nmikstas/atari_pokey/README.md

# atari_pokey
Recreation of the Atari POKEY chip (work in progress)
