nmikstas/atari_pokey/Documents/FPGA_POKEY_Schematic/page1.png

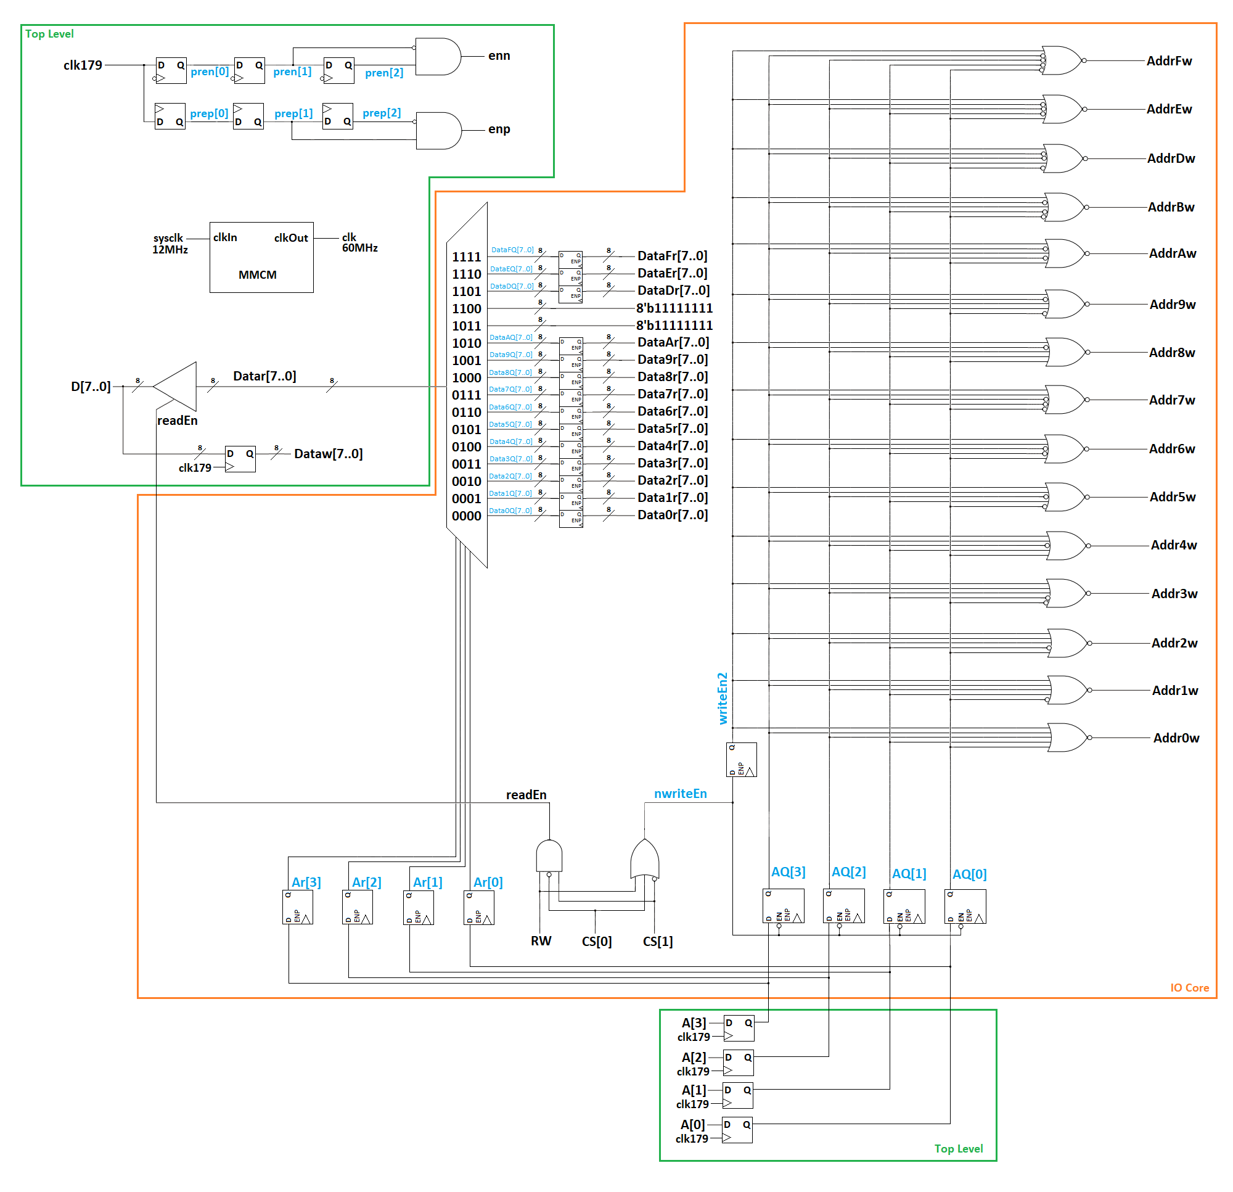
Documents/FPGA_POKEY_Schematic/page1.png
