nmikstas/atari_pokey/Documents/FPGA_POKEY_Schematic/page2.png

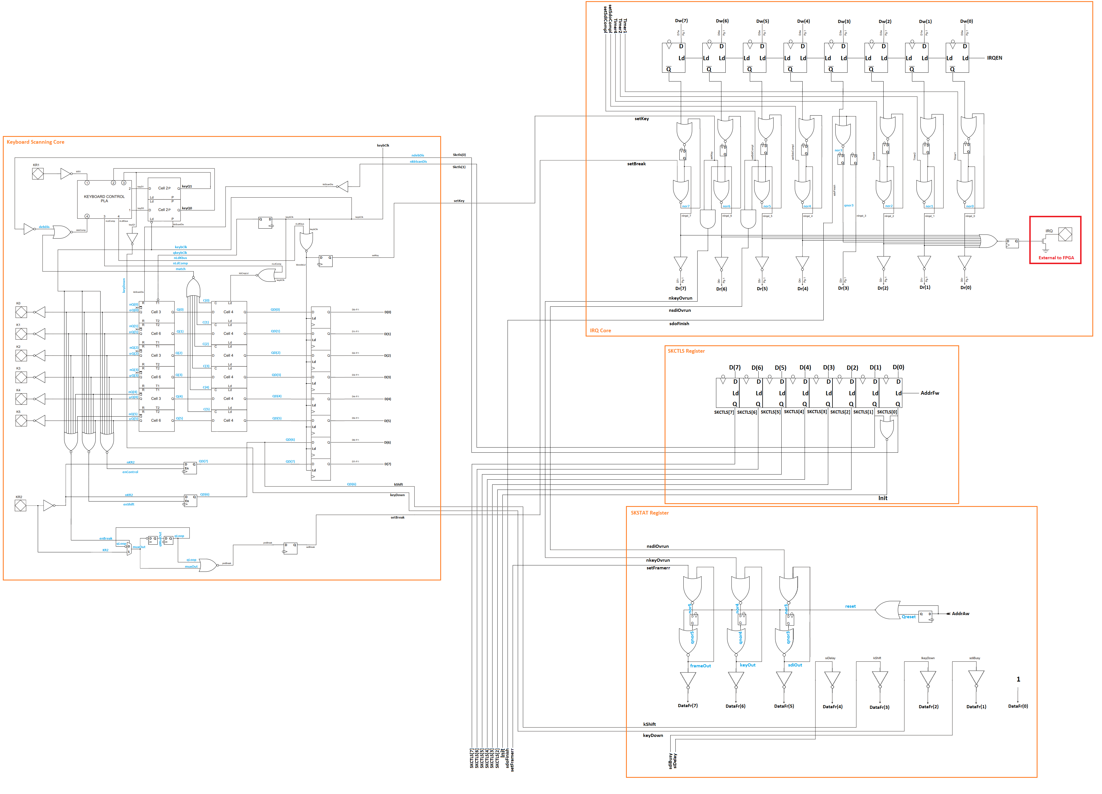
Documents/FPGA_POKEY_Schematic/page2.png
