nmikstas/atari_pokey/Documents/FPGA_POKEY_Schematic/page3.png

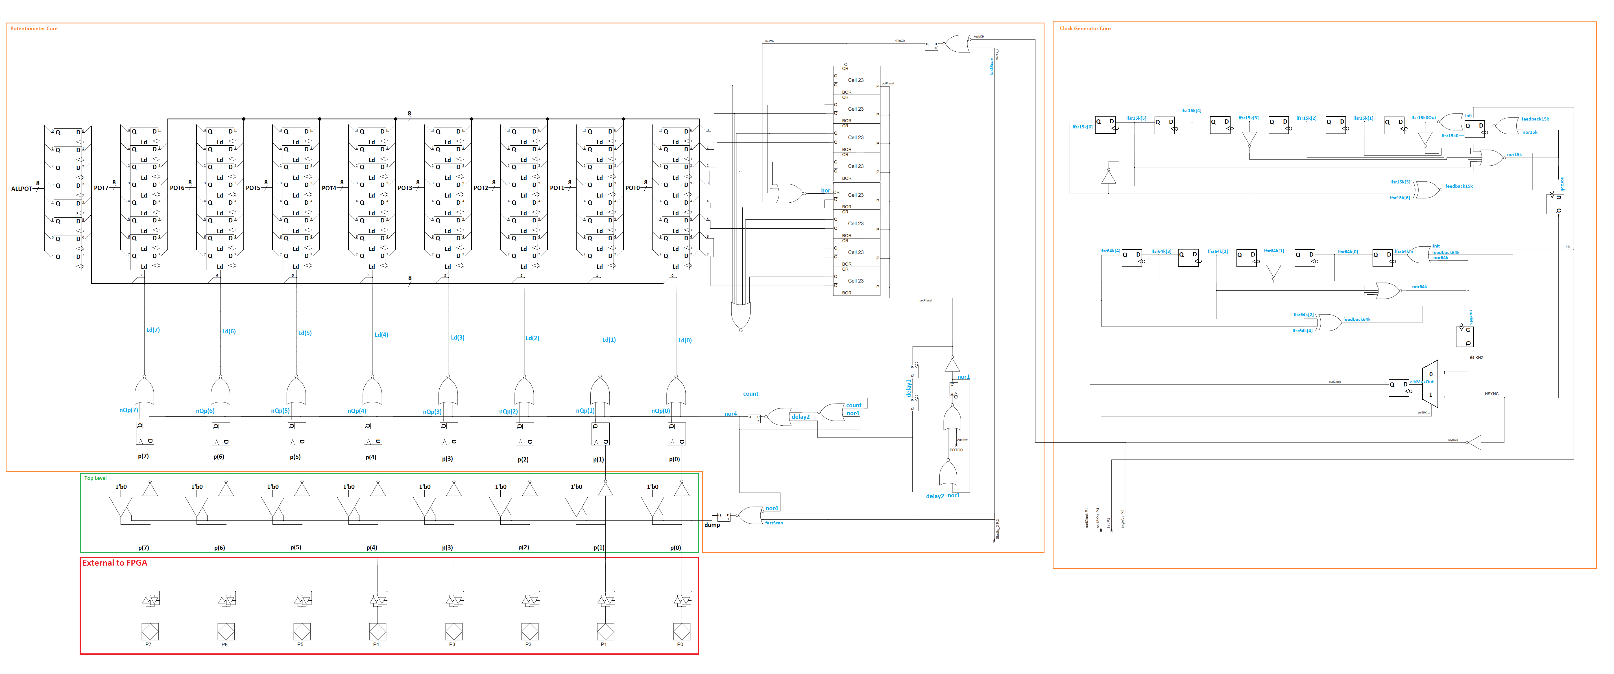
Documents/FPGA_POKEY_Schematic/page3.png
