nmikstas/atari_pokey/Documents/FPGA_POKEY_Schematic/page4.png

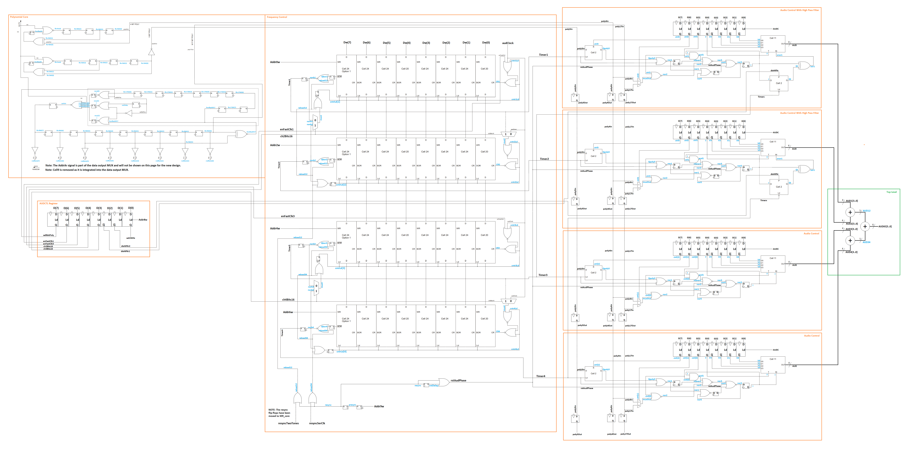
Documents/FPGA_POKEY_Schematic/page4.png
