nmikstas/atari_pokey/Documents/FPGA_POKEY_Schematic/page5.png

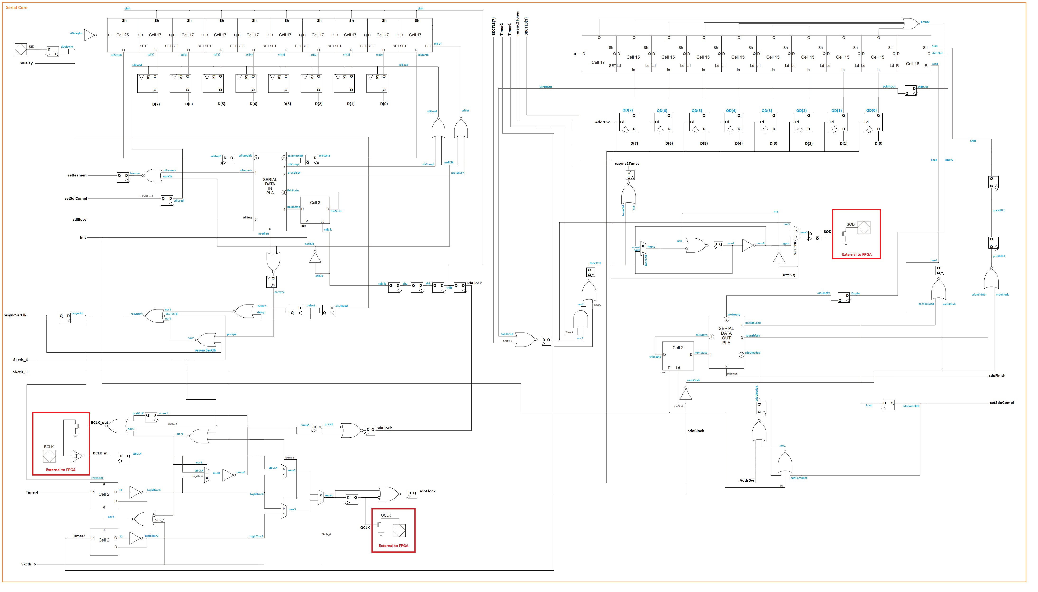
Documents/FPGA_POKEY_Schematic/page5.png
