nmikstas/atari_pokey/Documents/FPGA_POKEY_Schematic/page6.png

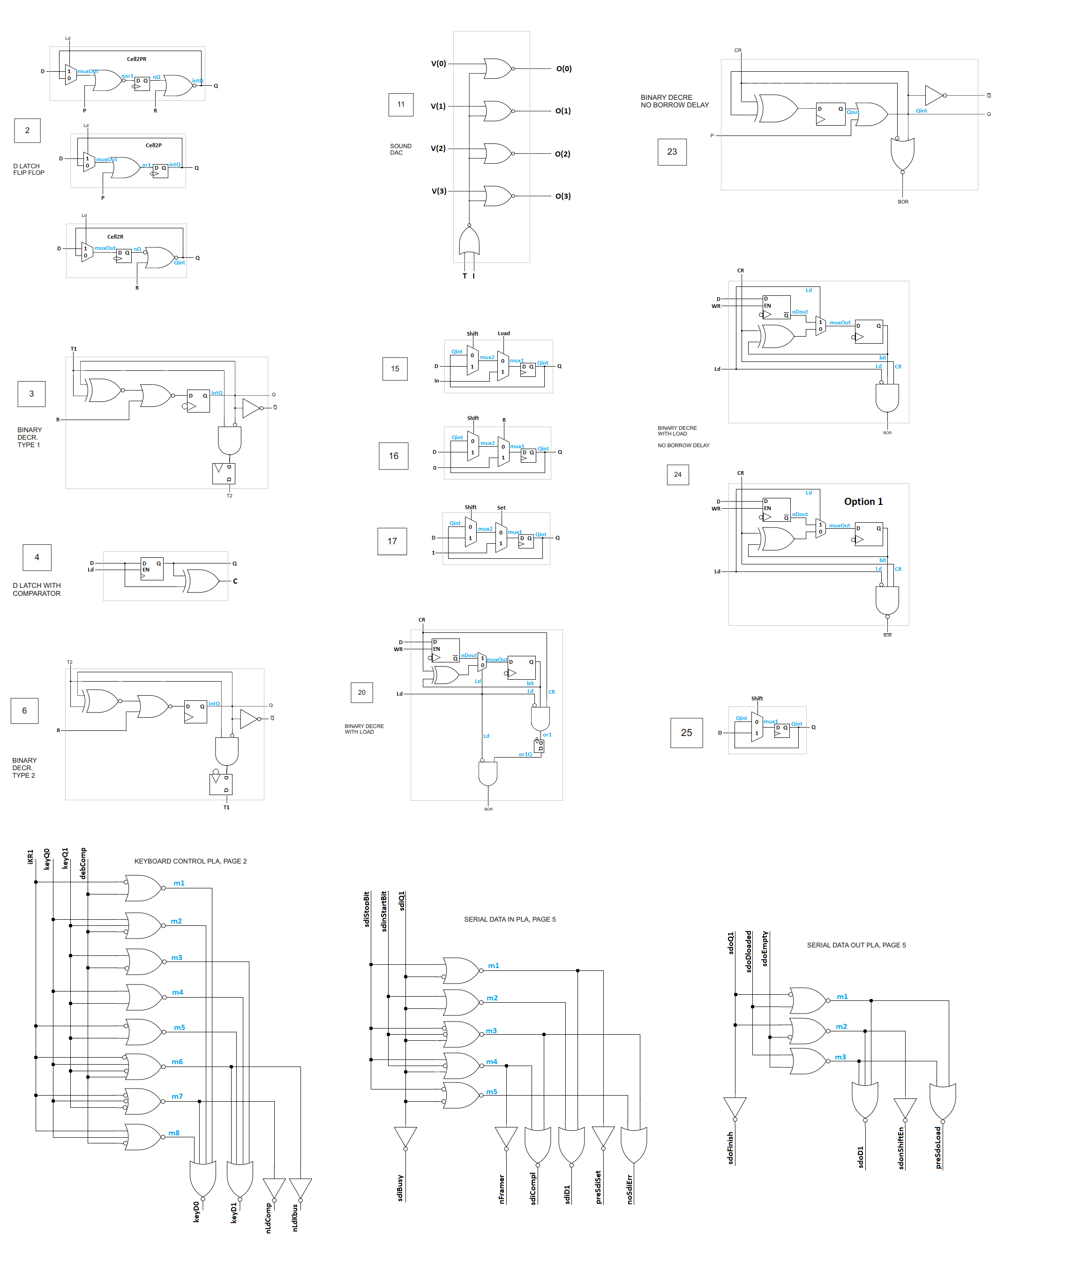
Documents/FPGA_POKEY_Schematic/page6.png
