nmikstas/atari_pokey/PCB/Prototype2/Manufacturing_Files/Prototype2.xls

Sheet: PCB Specification
Your PCB Specification
PCB Quantity | 5
Layer | 4
PCB Thickness | 1.6mm
Dimensions | 51mm x 64mm
Castellated Hole | No
PCB Color | Blue
Surface Finish
Copper Weight | 1 Oz
Text Color | White
Different Design | 1
Please find more PCB information on our on-line PCB ordering Page
https://www.elecrow.com/pcb-manufacturing.html

Sheet: BOM
BOM
Reference | QTY | Value | Package | Manufacturer Part number | Description | Part Number
C1 C2 C3 C4 C5 C6 C7 C8 C9 C10 | 10 | .1uf | 0201 (0603 Metric) | 0201X104K160CT | CAP CER 0.1UF 16V X5R 0201 | Digikey 1292-1161-1-ND or equivalent
C11 | 1 | 10uf | 0805 (2012 Metric) | CL21A106KOQNNNE | CAP CER 10UF 16V X5R 0805 | Digikey 1276-1096-1-ND or equivalent
Q1 Q2 Q3 Q4 Q5 Q6 Q7 Q8 Q9 Q10 Q11 Q12 Q13 Q14 Q15 Q16 Q17 Q18 | 18 | SSM3K72KCT | SC-101, SOT-883 | SSM3K72KCT,L3F | MOSFET N-CH 60V 400MA CST3 | Digikey SSM3K72KCTL3FCT-ND or equivalent
R1 | 1 | 825 1% | 0402 (1005 Metric) | RC0402FR-07825RL | RES 825 OHM 1% 1/16W 0402 | Digikey YAG3242CT-ND or equivalent
R2 | 1 | 1.65K 1% | 0201 (0603 Metric) | RC0201FR-071K65L | RES 1.65K OHM 1% 1/20W 0201 | Digikey YAG2486CT-ND or equivalent
R3 | 1 | 3.3K 1% | 0201 (0603 Metric) | RC0201FR-073K3L | RES 3.3K OHM 1% 1/20W 0201 | Digikey YAG2285CT-ND or equivalent
R4 | 1 | 7.68K 1% | 0201 (0603 Metric) | RC0201FR-077K68L | RES 7.68K OHM 1% 1/20W 0201 | Digikey YAG2806CT-ND or equivalent
R5 | 1 | 24K 1% | 0201 (0603 Metric) | RC0201FR-0724KL | RES 24K OHM 1% 1/20W 0201 | Digikey YAG2336CT-ND or equivalent
R6 | 1 | 75K 1% | 0201 (0603 Metric) | RC0201FR-0775KL | RES 75K OHM 1% 1/20W 0201 | Digikey YAG2795CT-ND or equivalent
U1 | 1 | 74LVC1G97 | 6-UFDFN | SN74LVC1G97DRYR | IC CONFIG MULTI-FUNC GATE 6SON | 296-29874-1-ND or equivalent
U2 | 1 | 74LVC245 | 20-VFQFN Exposed Pad | 74LVC245ABQ,115 | IC TXRX NON-INVERT 3.6V 20DHVQFN | 1727-3495-1-ND or equivalent
U3 U4 U5 | 3 | 74LVC3G14 | 8-XFDFN | 74LVC3G14GT,115 | IC INVERT SCHMITT 3CH 3INP 8XSON | 1727-7042-1-ND or equivalent
U6 U7 U8 U9 | 4 | 74LVC125 | 14-VFQFN Exposed Pad | 74LVC125ABQ,115 | IC BUF NON-INVERT 3.6V 14DHVQFN | 1727-3481-1-ND or equivalent
U10 | 1 | LD1117S33TR | SOT-223 | LD1117S33TR | IC REG LINEAR 3.3V 800MA SOT223 | 497-1242-1-ND or equivalent
TP1 TP2 TP3 TP4 TP5 TP6 TP7 TP8 TP9 TP10 TP11 TP12 TP13 TP14 TP15 TP16 TP17 TP18 TP19 TP20 TP21 TP22 TP23 TP24 TP25 TP26 TP27 TP28 TP29 TP30 TP31 TP32 TP33 TP34 TP35 TP36 TP37 TP38 TP39 TP40 TP41 TP42 TP43 TP44 TP45 TP46 | 46 | Not Populated
R6 | 1 | Not Populated
J2 | 1 | Not Populated
J3 | 1 | Not Populated

Sheet: Parts Mapping
Top View | Bottom View

Sheet: Position File
Designator | Footprint | Center-X(mm) | Center-Y(mm) | Layer | Rotation
C1 | C_0201_0603Metric | 172.212 | -71.2368 | Top | -90
C2 | C_0201_0603Metric | 183.2102 | -110.8495 | Top | -90
C3 | C_0201_0603Metric | 165.989 | -114.0816 | Top | -90
C4 | C_0201_0603Metric | 166.0678 | -103.886 | Top | 180
C5 | C_0201_0603Metric | 182.8292 | -82.5729 | Top | -90
C6 | C_0201_0603Metric | 166.0848 | -96.2660 | Top | 180
C7 | C_0201_0603Metric | 166.1322 | -88.6420 | Top | 180
C8 | C_0201_0603Metric | 174.3812 | -92.7100 | Top | 0.0000
C9 | C_0201_0603Metric | 156.3776 | -62.6872 | Top | 0.0000
C10 | C_0201_0603Metric | 165.989 | -80.7572 | Top | -90
C11 | C_0805_2012Metric | 156.337 | -60.2640 | Top | 90.0000
Q1 | CST3_TOS | 184.2135 | -74.9300 | Top | 0.0000
Q2 | CST3_TOS | 188.2775 | -74.93 | Top | 180
Q3 | CST3_TOS | 184.2135 | -73.4060 | Top | 0.0000
Q4 | CST3_TOS | 188.2775 | -73.4060 | Top | 180
Q5 | CST3_TOS | 184.2135 | -71.8820 | Top | 0.0000
Q6 | CST3_TOS | 188.2775 | -71.8820 | Top | 180
Q7 | CST3_TOS | 162.814 | -101.5365 | Top | -90
Q8 | CST3_TOS | 162.814 | -104.0765 | Top | -90
Q9 | CST3_TOS | 162.814 | -96.4565 | Top | -90
Q10 | CST3_TOS | 162.814 | -98.9965 | Top | -90
Q11 | CST3_TOS | 162.814 | -91.3765 | Top | -90
Q12 | CST3_TOS | 162.814 | -93.9165 | Top | -90
Q13 | CST3_TOS | 162.814 | -86.2965 | Top | -90
Q14 | CST3_TOS | 162.814 | -88.8365 | Top | -90
Q15 | CST3_TOS | 181.9783 | -104.1400 | Top | 180
Q16 | CST3_TOS | 181.9529 | -101.6000 | Top | 180
Q17 | CST3_TOS | 181.864 | -96.5200 | Top | 180
Q18 | CST3_TOS | 181.9275 | -99.0600 | Top | 180
R1 | R_0402_1005Metric | 185.674 | -75.186 | Top | -90
R2 | R_0201_0603Metric | 186.944 | -75.021 | Top | -90
R3 | R_0201_0603Metric | 185.674 | -73.406 | Top | 90.0000
R4 | R_0201_0603Metric | 186.944 | -73.315 | Top | 90.0000
R5 | R_0201_0603Metric | 185.674 | -71.791 | Top | -90
R6 | R_0201_0603Metric | 186.944 | -71.719 | Top | -90
U1 | DRY6 | 172.4516 | -92.7100 | Top | 0.0000
U2 | VQFN20_RKS_TEX | 168.6757 | -70.6882 | Top | -90
U3 | XSON8 | 168.4408 | -104.1324 | Top | 90.0000
U4 | XSON8 | 168.4408 | -96.5022 | Top | 90.0000
U5 | XSON8 | 168.4408 | -88.9330 | Top | 90.0000
U6 | DHVQFN14_SOT762-1_NEX | 168.7068 | -114.1476 | Top | 90.0000
U7 | DHVQFN14_SOT762-1_NEX | 185.8772 | -110.8964 | Top | 90.0000
U8 | DHVQFN14_SOT762-1_NEX | 168.7068 | -80.7720 | Top | 90.0000
U9 | DHVQFN14_SOT762-1_NEX | 185.6232 | -82.6389 | Top | 90.0000
U10 | SOT-223 | 162.535 | -61.8490 | Top | 0.0000
