nmikstas/atari_pokey/PCB/Through_Hole_Single_Lattice/Through_Hole_Single.kicad_pcb

## KiCad design PCB/Through_Hole_Single_Lattice/Through_Hole_Single.kicad_pcb (2024-12-10)

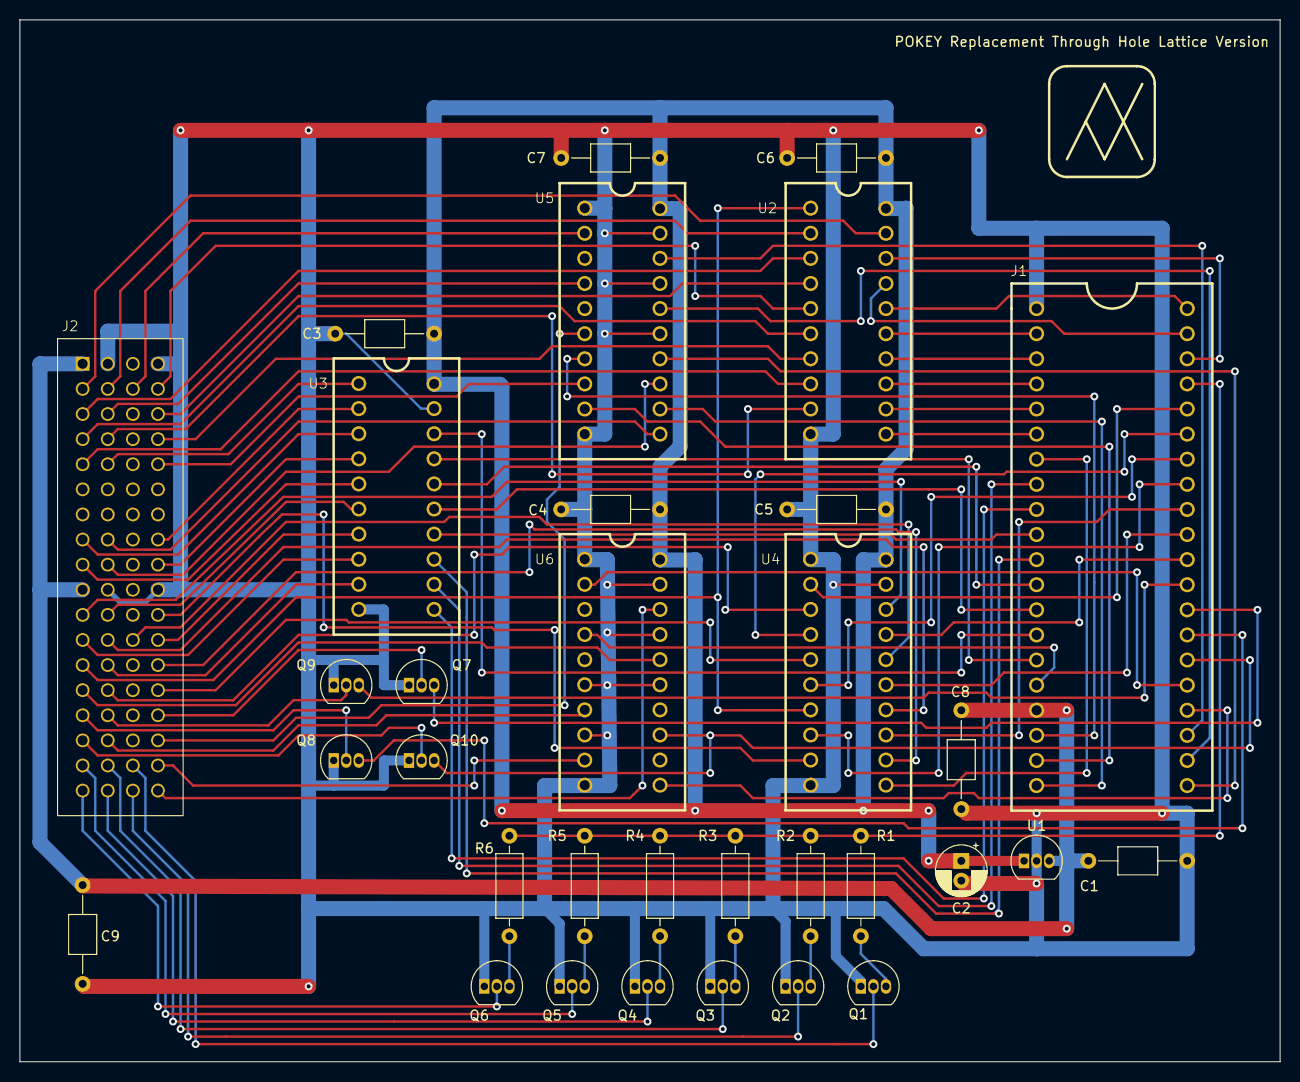
[picture p7: board Through_Hole_Single.kicad_pcb from above]

Board: 2 copper layers, 127.5 x 105.4 mm, 33 parts (0 on the bottom side), 93 nets.

Parts:
C1, C3, C4, C5, C6, C7, C8, C9: .1uf; C_Axial_L3.8mm_D2.6mm_P10.00mm_Horizontal
C2: 10uf; CP_Radial_D5.0mm_P2.00mm
J1: 2x20_Conn; Con_2X20
J2: Proto-72Pin
Q1, Q2, Q3, Q4, Q5, Q6, Q7, Q8, Q9, Q10: TN2106; TO-92_Inline
R1: 825 1%; R_Axial_DIN0207_L6.3mm_D2.5mm_P10.16mm_Horizontal
R2: 1.65K 1%; R_Axial_DIN0207_L6.3mm_D2.5mm_P10.16mm_Horizontal
R3: 3.3K 1%; R_Axial_DIN0207_L6.3mm_D2.5mm_P10.16mm_Horizontal
R4: 7.68K 1%; R_Axial_DIN0207_L6.3mm_D2.5mm_P10.16mm_Horizontal
R5: 24K 1%; R_Axial_DIN0207_L6.3mm_D2.5mm_P10.16mm_Horizontal
R6: 75K 1%; R_Axial_DIN0207_L6.3mm_D2.5mm_P10.16mm_Horizontal
U1: L78L05_TO92; TO-92_Inline
U2, U3, U4, U5, U6: DIP_20

Connections:
+3.3V: C2.1, C3.1, C4.1, C5.1, C6.1, C7.1, U1.1 (VO), U2.20 (VCC), U3.20 (VCC), U4.20 (VCC), U5.20 (VCC), U6.20 (VCC)
+5V: C1.1, C8.1, C9.1, J1.17 (+5V), J2.1 (5V1), J2.37 (5V2), U1.3 (VI)
A0: J1.36 (A0), U4.2 (1A1)
A1: J1.35 (A1), U4.4 (1A2)
A2: J1.34 (A2), U4.6 (1A3)
A3: J1.33 (A3), U4.8 (1A4)
AUDIO: J1.37 (AUDIO), R1.1, R2.1, R3.1, R4.1, R5.1, R6.1
BCLK: J1.26 (BCLK), Q10.3 (D), U6.13 (2A2)
CS1: J1.31 (CS1), U4.15 (2A3)
D0: J1.38 (D0), U2.18 (B0)
D1: J1.39 (D1), U2.17 (B1)
D2: J1.40 (D2), U2.16 (B2)
D3: J1.2 (D3), U2.15 (B3)
D4: J1.3 (D4), U2.14 (B4)
D5: J1.4 (D5), U2.13 (B5)
D6: J1.5 (D6), U2.12 (B6)
D7: J1.6 (D7), U2.11 (B7)
GND: C1.2, C2.2, C3.2, C4.2, C5.2, C6.2, C7.2, C8.2, C9.2, J1.1 (GND), J2.2 (G1), J2.4 (G2), J2.38 (G3), J2.40 (G4), Q1.1 (S), Q2.1 (S), Q3.1 (S), Q4.1 (S), Q5.1 (S), Q6.1 (S), Q7.1 (S), Q8.1 (S), Q9.1 (S), Q10.1 (S), U1.2 (GND), U2.10 (GND), U3.10 (GND), U3.19 (CE), U4.1 (1~OE), U4.10 (GND), U4.19 (2~OE), U5.1 (1~OE), U5.10 (GND), U5.15 (2A3), U5.17 (2A4), U5.19 (2~OE), U6.1 (1~OE), U6.6 (1A3), U6.8 (1A4), U6.10 (GND), U6.15 (2A3), U6.17 (2A4), U6.19 (2~OE)
unnamed: Q1.3 (D), R1.2
unnamed: Q2.3 (D), R2.2
unnamed: Q3.3 (D), R3.2
unnamed: Q4.3 (D), R4.2
unnamed: Q5.3 (D), R5.2
unnamed: Q6.3 (D), R6.2
OCLK: J1.27 (OCLK), Q8.3 (D)
P0: J1.14 (P0), U3.18 (B0)
P1: J1.15 (P1), U3.17 (B1)
P2: J1.12 (P2), U3.16 (B2)
P3: J1.13 (P3), U3.15 (B3)
P4: J1.10 (P4), U3.14 (B4)
P5: J1.11 (P5), U3.13 (B5)
P6: J1.8 (P6), U3.12 (B6)
P7: J1.9 (P7), U3.11 (B7)
PHI2: J1.7 (PHI2), U4.11 (2A1)
R/W: J1.32 (R/W), U4.13 (2A2)
SID: J1.24 (SID), U6.11 (2A1)
SOD: J1.28 (SOD), Q7.3 (D)
_A0: J2.41 (B48), U4.18 (1Y1)
_A1: J2.47 (B6), U4.16 (1Y2)
_A2: J2.46 (B46), U4.14 (1Y3)
_A3: J2.52 (B8), U4.12 (1Y4)
_AUDIO0: J2.69 (B27), Q6.2 (G)
_AUDIO1: J2.65 (B30), Q5.2 (G)
_AUDIO2: J2.70 (B28), Q4.2 (G)
_AUDIO3: J2.66 (B31), Q3.2 (G)
_AUDIO4: J2.71 (B24), Q2.2 (G)
_AUDIO5: J2.67 (B21), Q1.2 (G)
_BCLKI: J2.62 (B34), U6.7 (2Y2)
_BCLKO: J2.61 (B33), Q10.2 (G)
_CS1: J2.56 (B11), U4.5 (2Y3)
_D0: J2.6 (A49), U2.2 (A0)
_D1: J2.9 (A45), U2.3 (A1)
_D2: J2.12 (A5), U2.4 (A2)
_D3: J2.8 (A2), U2.5 (A3)
_D4: J2.13 (A42), U2.6 (A4)
_D5: J2.16 (A8), U2.7 (A5)
_D6: J2.17 (A39), U2.8 (A6)
_D7: J2.14 (A43), U2.9 (A7)
_DUMP: J2.18 (A40), U3.1 (A->B)
_OCLK: J2.57 (B36), Q8.2 (G)
_P0: J2.32 (A20), U3.2 (A0)
_P1: J2.29 (A30), U3.3 (A1)
_P2: J2.36 (A23), U3.4 (A2)
_P3: J2.33 (A27), U3.5 (A3)
_P4: J2.42 (B49), U3.6 (A4)
_P5: J2.48 (B5), U3.7 (A5)
_P6: J2.45 (B45), U3.8 (A6)
_P7: J2.50 (B43), U3.9 (A7)
_PHI2: J2.44 (B2), U4.9 (2Y1)
_R/W: J2.49 (B42), U2.1 (A->B), U4.7 (2Y2)
_SID: J2.68 (B20), U6.9 (2Y1)
_SOD: J2.60 (B14), Q7.2 (G)
_~CS0: J2.54 (B40), U4.3 (2Y4)
_~IRQ: J2.58 (B37), Q9.2 (G)
_~K0: J2.7 (A3), U5.2 (1A1)
_~K1: J2.10 (A46), U5.4 (1A2)
_~K2: J2.64 (B17), U5.6 (1A3)
_~K3: J2.20 (A11), U5.8 (1A4)
_~K4: J2.30 (A31), U5.11 (2A1)
_~K5: J2.34 (A28), U5.13 (2A2)
_~KR1: J2.72 (B23), U6.18 (1Y1)
_~KR2: J2.53 (B39), U6.16 (1Y2)
~CS0: J1.30 (~CS0), U4.17 (2A4)
~IRQ: J1.29 (~IRQ), Q9.3 (D)
~K0: J1.23 (~K0), U5.18 (1Y1)
~K1: J1.22 (~K1), U5.16 (1Y2)
~K2: J1.21 (~K2), U5.14 (1Y3)
~K3: J1.20 (~K3), U5.12 (1Y4)
~K4: J1.19 (~K4), U5.9 (2Y1)
~K5: J1.18 (~K5), U5.7 (2Y2)
~KR1: J1.25 (~KR1), U6.2 (1A1)
~KR2: J1.16 (~KR2), U6.4 (1A2)
~_EN: J2.5 (A48), U2.19 (CE)
