nmikstas/atari_pokey/PCB/Prototype2/Prototype2.kicad_pcb

## KiCad design PCB/Prototype2/Prototype2.kicad_pcb (2024-10-20)

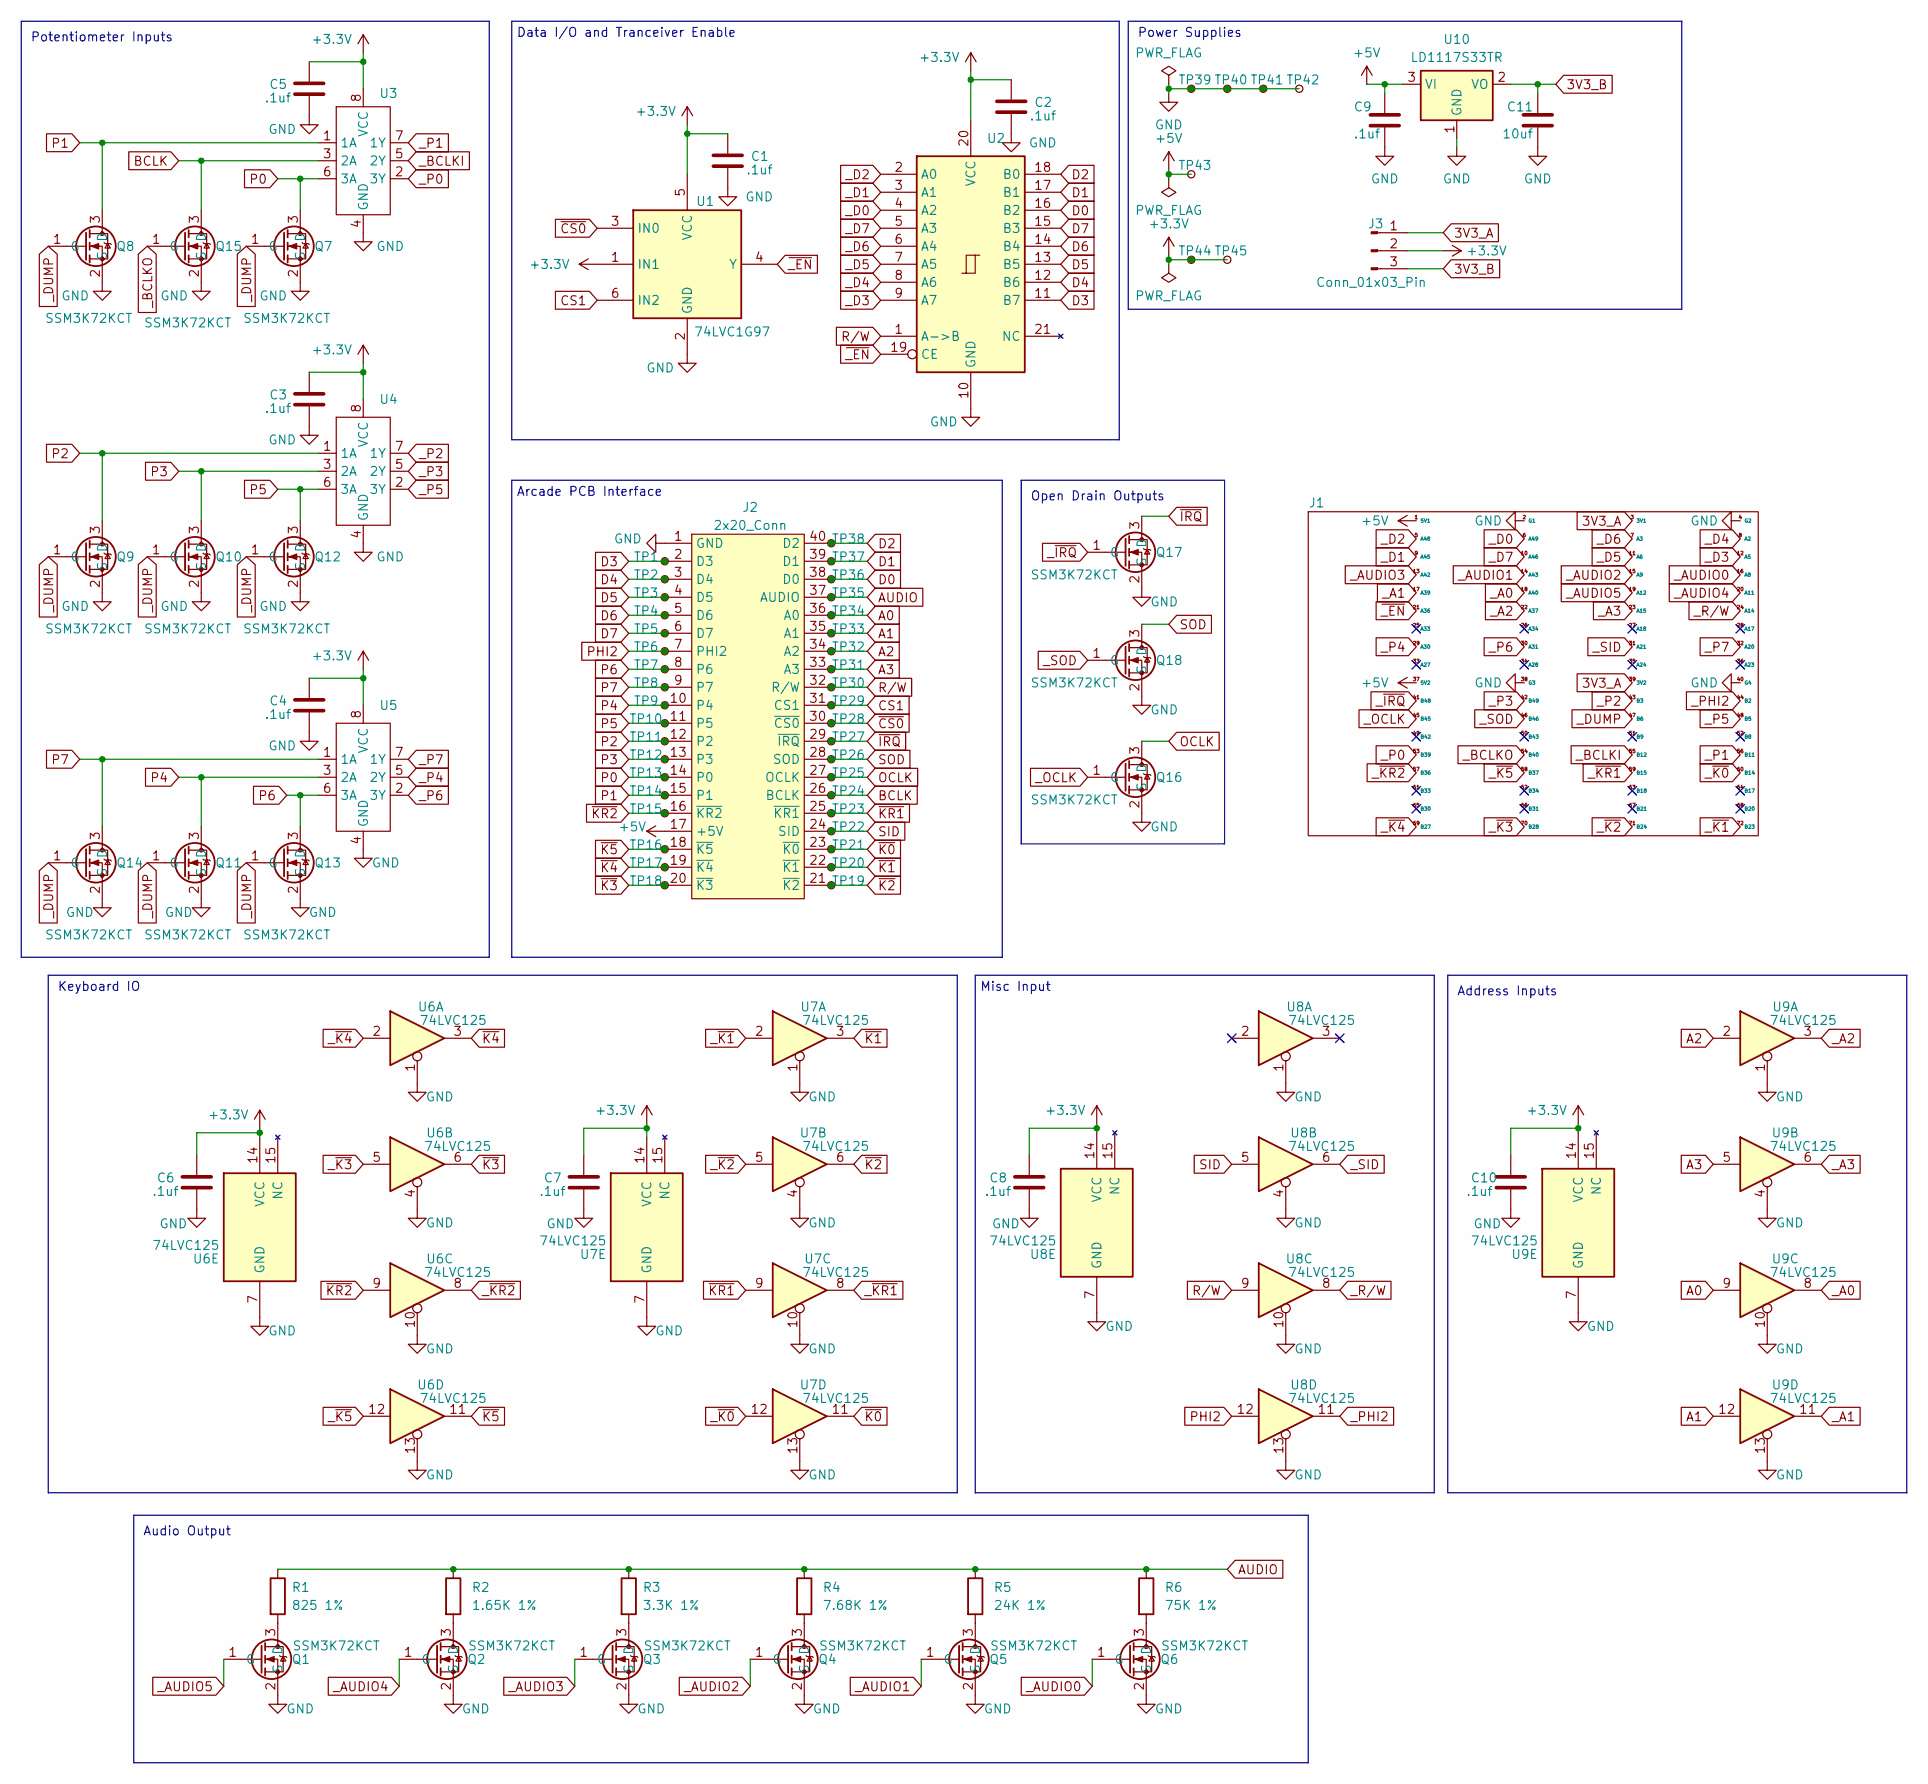
[picture p8: schematic Prototype2.kicad_sch]

Parts:
C1, C2, C3, C4, C5, C6, C7, C8, C9, C10: .1uf; C_0201_0603Metric
C11: 10uf; C_0805_2012Metric
J1: Proto-72Pin
J2: 2x20_Conn; Con_2X20
J3: Conn_01x03_Pin; PinSocket_1x03_P2.54mm_Vertical
Q1, Q2, Q3, Q4, Q5, Q6, Q7, Q8, Q9, Q10, Q11, Q12, Q13, Q14, Q15, Q16, Q17, Q18: SSM3K72KCT; CST3_TOS
R1: 825 1%; R_0402_1005Metric
R2: 1.65K 1%; R_0201_0603Metric
R3: 3.3K 1%; R_0201_0603Metric
R4: 7.68K 1%; R_0201_0603Metric
R5: 24K 1%; R_0201_0603Metric
R6: 75K 1%; R_0201_0603Metric
TP1, TP2, TP3, TP4, TP5, TP6, TP7, TP8, TP9, TP10, TP11, TP12, TP13, TP14, TP15, TP16, TP17, TP18, TP19, TP20, TP21, TP22, TP23, TP24, TP25, TP26, TP27, TP28, TP29, TP30, TP31, TP32, TP33, TP34, TP35, TP36, TP37, TP38, TP39, TP40, TP41, TP42, TP43, TP44, TP45: TP
U1: 74LVC1G97; DRY6
U2: VQFN20_RKS_TEX
U3, U4, U5: XSON8
U6, U7, U8, U9: 74LVC125; DHVQFN14_SOT762-1_NEX
U10: LD1117S33TR; Reg

Connections:
3V3_A: J1.3 (3V1), J1.39 (3V2), J3.1
3V3_B: C11.1, J3.3, U10.2 (VO)
+3.3V: C1.1, C2.1, C3.1, C4.1, C5.1, C6.1, C7.1, C8.1, C10.1, J3.2, TP44.1, TP45.1, U1.1 (IN1), U1.5 (VCC), U2.20 (VCC), U3.8 (VCC), U4.8 (VCC), U5.8 (VCC), U6.14 (VCC), U7.14 (VCC), U8.14 (VCC), U9.14 (VCC)
+5V: C9.1, J1.1 (5V1), J1.37 (5V2), J2.17 (+5V), TP43.1, U10.3 (VI)
A0: J2.36 (A0), TP34.1, U9.9
A1: J2.35 (A1), TP33.1, U9.12
A2: J2.34 (A2), TP32.1, U9.2
A3: J2.33 (A3), TP31.1, U9.5
AUDIO: J2.37 (AUDIO), R1.1, R2.1, R3.1, R4.1, R5.1, R6.1, TP35.1
BCLK: J2.26 (BCLK), Q15.3 (D), TP24.1, U3.3 (2A)
CS1: J2.31 (CS1), TP29.1, U1.6 (IN2)
D0: J2.38 (D0), TP36.1, U2.16 (B2)
D1: J2.39 (D1), TP37.1, U2.17 (B1)
D2: J2.40 (D2), TP38.1, U2.18 (B0)
D3: J2.2 (D3), TP1.1, U2.11 (B7)
D4: J2.3 (D4), TP2.1, U2.12 (B6)
D5: J2.4 (D5), TP3.1, U2.13 (B5)
D6: J2.5 (D6), TP4.1, U2.14 (B4)
D7: J2.6 (D7), TP5.1, U2.15 (B3)
GND: C1.2, C2.2, C3.2, C4.2, C5.2, C6.2, C7.2, C8.2, C9.2, C10.2, C11.2, J1.2 (G1), J1.4 (G2), J1.38 (G3), J1.40 (G4), J2.1 (GND), Q1.2 (S), Q2.2 (S), Q3.2 (S), Q4.2 (S), Q5.2 (S), Q6.2 (S), Q7.2 (S), Q8.2 (S), Q9.2 (S), Q10.2 (S), Q11.2 (S), Q12.2 (S), Q13.2 (S), Q14.2 (S), Q15.2 (S), Q16.2 (S), Q17.2 (S), Q18.2 (S), TP39.1, TP40.1, TP41.1, TP42.1, U1.2 (GND), U2.10 (GND), U3.4 (GND), U4.4 (GND), U5.4 (GND), U6.1, U6.4, U6.7 (GND), U6.10, U6.13, U7.1, U7.4, U7.7 (GND), U7.10, U7.13, U8.1, U8.4, U8.7 (GND), U8.10, U8.13, U9.1, U9.4, U9.7 (GND), U9.10, U9.13, U10.1 (GND)
unnamed: Q1.3 (D), R1.2
unnamed: Q2.3 (D), R2.2
unnamed: Q3.3 (D), R3.2
unnamed: Q4.3 (D), R4.2
unnamed: Q5.3 (D), R5.2
unnamed: Q6.3 (D), R6.2
OCLK: J2.27 (OCLK), Q16.3 (D), TP25.1
P0: J2.14 (P0), Q7.3 (D), TP13.1, U3.6 (3A)
P1: J2.15 (P1), Q8.3 (D), TP14.1, U3.1 (1A)
P2: J2.12 (P2), Q9.3 (D), TP11.1, U4.1 (1A)
P3: J2.13 (P3), Q10.3 (D), TP12.1, U4.3 (2A)
P4: J2.10 (P4), Q11.3 (D), TP9.1, U5.3 (2A)
P5: J2.11 (P5), Q12.3 (D), TP10.1, U4.6 (3A)
P6: J2.8 (P6), Q13.3 (D), TP7.1, U5.6 (3A)
P7: J2.9 (P7), Q14.3 (D), TP8.1, U5.1 (1A)
PHI2: J2.7 (PHI2), TP6.1, U8.12
R/W: J2.32 (R/W), TP30.1, U2.1 (A->B), U8.9
SID: J2.24 (SID), TP22.1, U8.5
SOD: J2.28 (SOD), Q18.3 (D), TP26.1
_A0: J1.18 (A40), U9.8
_A1: J1.17 (A39), U9.11
_A2: J1.22 (A37), U9.3
_A3: J1.23 (A15), U9.6
_AUDIO0: J1.16 (A8), Q6.1 (G)
_AUDIO1: J1.14 (A43), Q5.1 (G)
_AUDIO2: J1.15 (A9), Q4.1 (G)
_AUDIO3: J1.13 (A42), Q3.1 (G)
_AUDIO4: J1.20 (A11), Q2.1 (G)
_AUDIO5: J1.19 (A12), Q1.1 (G)
_BCLKI: J1.55 (B12), U3.5 (2Y)
_BCLKO: J1.54 (B40), Q15.1 (G)
_D0: J1.6 (A49), U2.4 (A2)
_D1: J1.9 (A45), U2.3 (A1)
_D2: J1.5 (A48), U2.2 (A0)
_D3: J1.12 (A5), U2.9 (A7)
_D4: J1.8 (A2), U2.8 (A6)
_D5: J1.11 (A6), U2.7 (A5)
_D6: J1.7 (A3), U2.6 (A4)
_D7: J1.10 (A46), U2.5 (A3)
_DUMP: J1.47 (B6), Q7.1 (G), Q8.1 (G), Q9.1 (G), Q10.1 (G), Q11.1 (G), Q12.1 (G), Q13.1 (G), Q14.1 (G)
_OCLK: J1.45 (B45), Q16.1 (G)
_P0: J1.53 (B39), U3.2 (3Y)
_P1: J1.56 (B11), U3.7 (1Y)
_P2: J1.43 (B3), U4.7 (1Y)
_P3: J1.42 (B49), U4.5 (2Y)
_P4: J1.29 (A30), U5.5 (2Y)
_P5: J1.48 (B5), U4.2 (3Y)
_P6: J1.30 (A31), U5.2 (3Y)
_P7: J1.32 (A20), U5.7 (1Y)
_PHI2: J1.44 (B2), U8.11
_R/W: J1.24 (A14), U8.8
_SID: J1.31 (A21), U8.6
_SOD: J1.46 (B46), Q18.1 (G)
_~IRQ: J1.41 (B48), Q17.1 (G)
_~K0: J1.60 (B14), U7.12
_~K1: J1.72 (B23), U7.2
_~K2: J1.71 (B24), U7.5
_~K3: J1.70 (B28), U6.5
_~K4: J1.69 (B27), U6.2
_~K5: J1.58 (B37), U6.12
_~KR1: J1.59 (B15), U7.8
_~KR2: J1.57 (B36), U6.8
~CS0: J2.30 (~CS0), TP28.1, U1.3 (IN0)
~IRQ: J2.29 (~IRQ), Q17.3 (D), TP27.1
~K0: J2.23 (~K0), TP21.1, U7.11
~K1: J2.22 (~K1), TP20.1, U7.3
~K2: J2.21 (~K2), TP19.1, U7.6
~K3: J2.20 (~K3), TP18.1, U6.6
~K4: J2.19 (~K4), TP17.1, U6.3
~K5: J2.18 (~K5), TP16.1, U6.11
~KR1: J2.25 (~KR1), TP23.1, U7.9
~KR2: J2.16 (~KR2), TP15.1, U6.9
~_EN: J1.21 (A36), U1.4 (Y), U2.19 (CE)

Notes on the sheet:
Keyboard IO
Power Supplies
Potentiometer Inputs
Arcade PCB Interface
Data I/O and Tranceiver Enable
Audio Output
Address Inputs
Misc Input
Open Drain Outputs

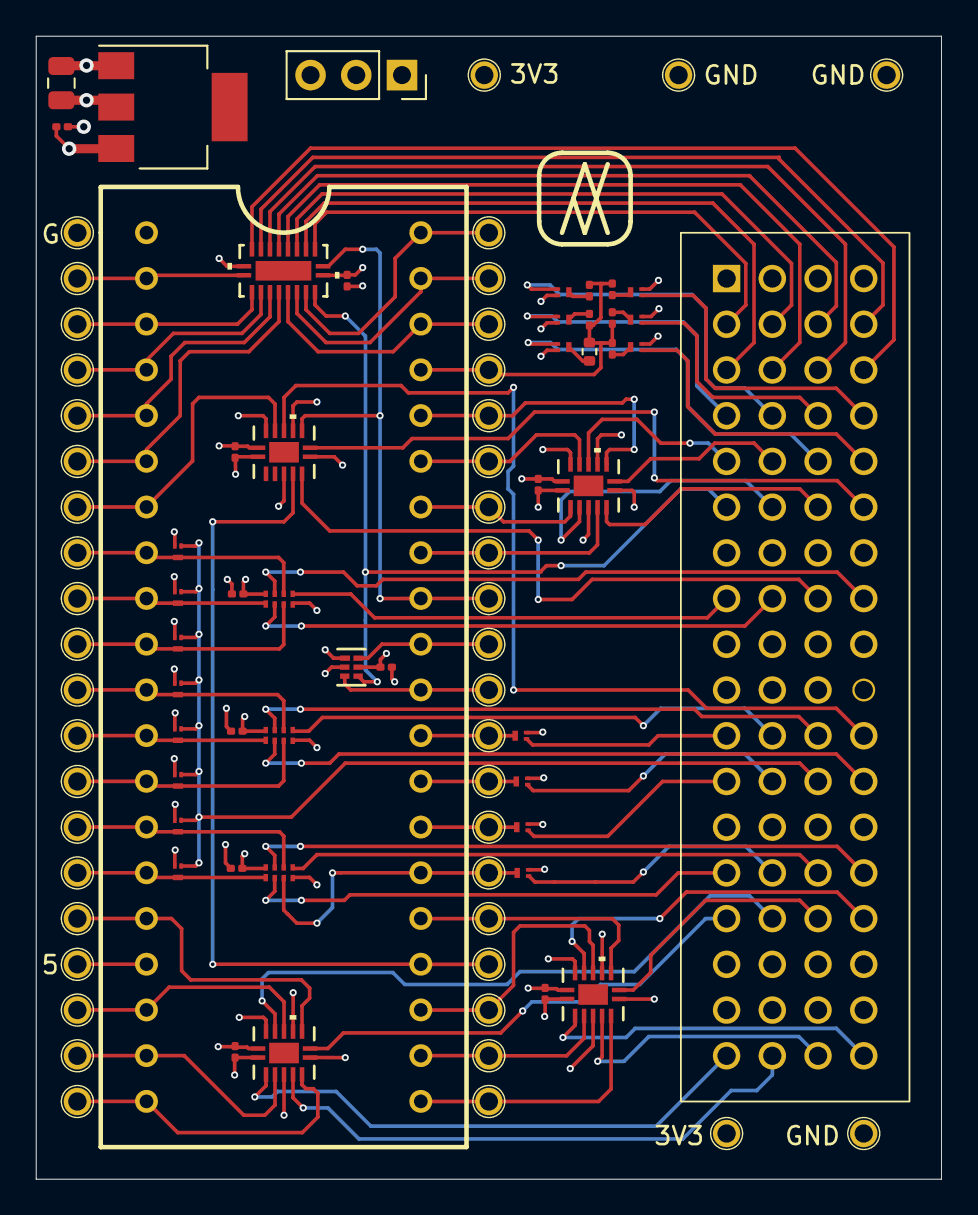
[picture p9: board Prototype2.kicad_pcb from above]

Board: 4 copper layers, 50.3 x 63.5 mm, 93 parts (0 on the bottom side), 93 nets.
