nmikstas/atari_pokey/PCB/Quad_Prototype/Quad_Prototype.kicad_pcb

## KiCad design PCB/Quad_Prototype/Quad_Prototype.kicad_pcb (2024-11-11)

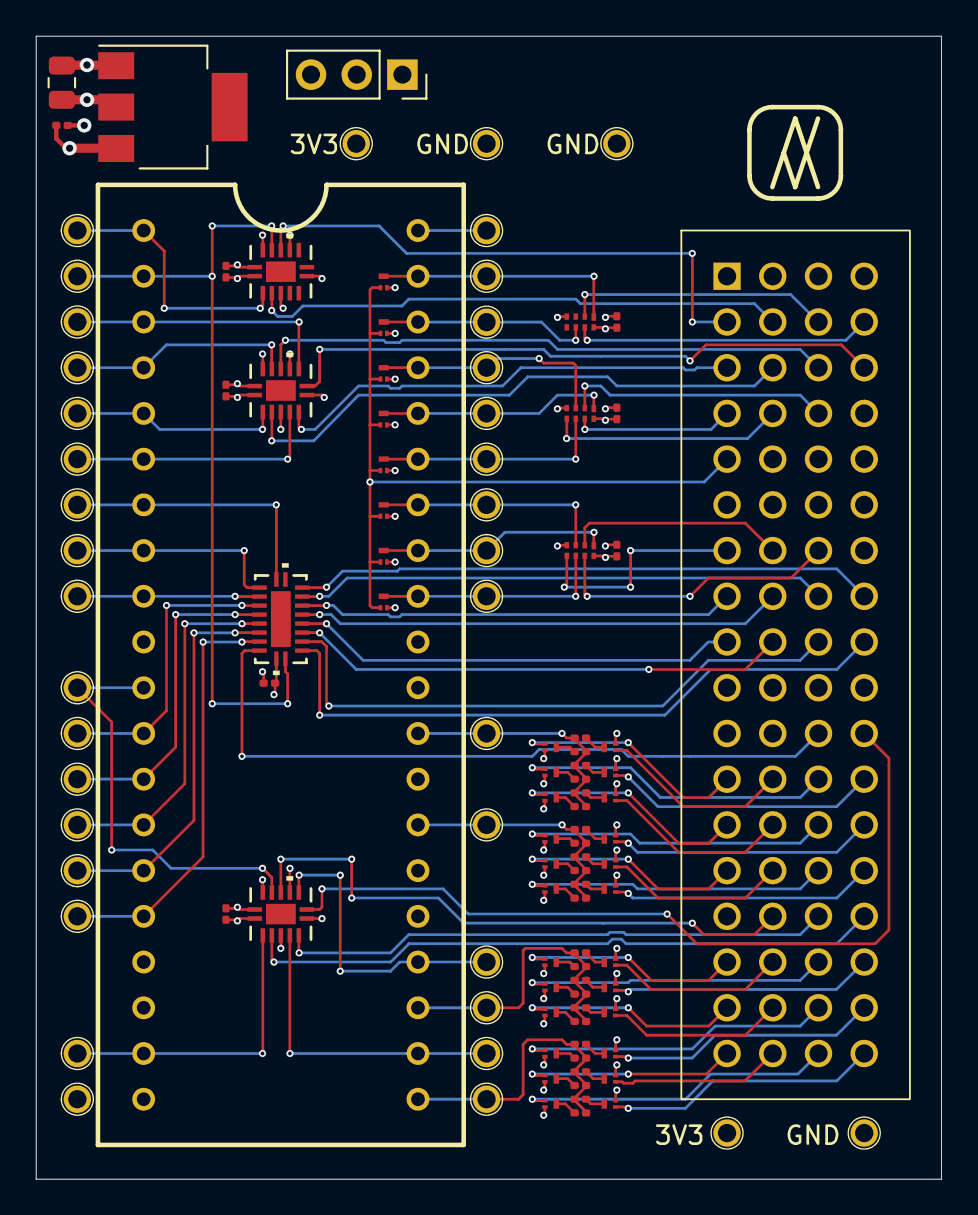
[picture p10: board Quad_Prototype.kicad_pcb from above]

Board: 4 copper layers, 50.3 x 63.5 mm, 113 parts (0 on the bottom side), 111 nets.

Parts:
C1, C3, C4, C5, C6, C7, C8, C9: .1uf; C_0201_0603Metric
C2: 10uf; C_0805_2012Metric
J1: Con_2X20
J2: Proto-72Pin
J3: Conn_01x03_Pin; PinSocket_1x03_P2.54mm_Vertical
Q1, Q2, Q3, Q4, Q5, Q6, Q7, Q8, Q9, Q10, Q11, Q12, Q13, Q14, Q15, Q16, Q17, Q18, Q19, Q20, Q21, Q22, Q23, Q24, Q25, Q26, Q27, Q29, Q30, Q31, Q32, Q33: SSM3K72KCT; CST3_TOS
R1, R7, R13, R19: 825 1%; R_0201_0603Metric
R2, R8, R14, R20: 1.65K 1%; R_0201_0603Metric
R3, R9, R15, R21: 3.3K 1%; R_0201_0603Metric
R4, R10, R16, R22: 7.68K 1%; R_0201_0603Metric
R5, R11, R17, R23: 24K 1%; R_0201_0603Metric
R6, R12, R18, R24: 75K 1%; R_0201_0603Metric
TP1, TP2, TP3, TP4, TP5, TP6, TP7, TP8, TP9, TP10, TP11, TP12, TP13, TP14, TP15, TP16, TP17, TP18, TP19, TP20, TP21, TP22, TP23, TP24, TP25, TP26, TP27, TP28, TP29, TP30, TP31, TP32, TP33, TP34, TP35, TP36, TP37: TP
U1: LD1117S33TR; Reg
U2: VQFN20_RKS_TEX
U3, U7, U8: 74LVC125; DHVQFN14_SOT762-1_NEX
U4, U5, U6: XSON8

Connections:
3V3_A: J2.3 (3V1), J2.39 (3V2), J3.1
3V3_B: C2.1, J3.3, U1.2 (VO)
+3.3V: C3.1, C4.1, C5.1, C6.1, C7.1, C8.1, C9.1, J3.2, TP3.1, TP5.1, U2.20 (VCC), U3.14 (VCC), U4.8 (VCC), U5.8 (VCC), U6.8 (VCC), U7.14 (VCC), U8.14 (VCC)
+5V: C1.1, J1.40 (VCC), J2.1 (5V1), J2.37 (5V2), TP2.1, U1.3 (VI)
A0: J1.6 (A0), TP13.1, U3.5
A1: J1.5 (A1), TP12.1, U3.2
A2: J1.4 (A2), TP11.1, U3.12
A3: J1.3 (A3), TP10.1, U3.9
AUDIO1: J1.23 (OUT1), R1.1, R2.1, R3.1, R4.1, R5.1, R6.1, TP26.1
AUDIO2: J1.29 (OUT2), R7.1, R8.1, R9.1, R10.1, R11.1, R12.1, TP29.1
AUDIO3: J1.27 (OUT3), R13.1, R14.1, R15.1, R16.1, R17.1, R18.1, TP28.1
AUDIO4: J1.21 (OUT4), R19.1, R20.1, R21.1, R22.1, R23.1, R24.1, TP24.1
D0: J1.7 (D0), TP14.1, U2.11 (B7)
D1: J1.8 (D1), TP15.1, U2.12 (B6)
D2: J1.9 (D2), TP16.1, U2.13 (B5)
D3: J1.12 (D3), TP18.1, U2.14 (B4)
D4: J1.13 (D4), TP19.1, U2.15 (B3)
D5: J1.14 (D5), TP20.1, U2.16 (B2)
D6: J1.15 (D6), TP21.1, U2.17 (B1)
D7: J1.16 (D7), TP22.1, U2.18 (B0)
GND: C1.2, C2.2, C3.2, C4.2, C5.2, C6.2, C7.2, C8.2, C9.2, J1.20 (GND), J2.2 (G1), J2.4 (G2), J2.38 (G3), J2.40 (G4), Q1.2 (S), Q2.2 (S), Q3.2 (S), Q4.2 (S), Q5.2 (S), Q6.2 (S), Q7.2 (S), Q8.2 (S), Q9.2 (S), Q10.2 (S), Q11.2 (S), Q12.2 (S), Q13.2 (S), Q14.2 (S), Q15.2 (S), Q16.2 (S), Q17.2 (S), Q18.2 (S), Q19.2 (S), Q20.2 (S), Q21.2 (S), Q22.2 (S), Q23.2 (S), Q24.2 (S), Q25.2 (S), Q26.2 (S), Q27.2 (S), Q29.2 (S), Q30.2 (S), Q31.2 (S), Q32.2 (S), Q33.2 (S), TP1.1, TP4.1, TP6.1, TP7.1, U1.1 (GND), U2.10 (GND), U3.1, U3.4, U3.7 (GND), U3.10, U3.13, U4.4 (GND), U5.4 (GND), U6.4 (GND), U7.1, U7.4, U7.7 (GND), U7.10, U7.13, U8.1, U8.4, U8.7 (GND), U8.10, U8.13
unnamed: Q1.3 (D), R1.2
unnamed: Q2.3 (D), R2.2
unnamed: Q3.3 (D), R3.2
unnamed: Q4.3 (D), R4.2
unnamed: Q5.3 (D), R5.2
unnamed: Q6.3 (D), R6.2
unnamed: Q7.3 (D), R7.2
unnamed: Q8.3 (D), R8.2
unnamed: Q9.3 (D), R9.2
unnamed: Q10.3 (D), R10.2
unnamed: Q11.3 (D), R11.2
unnamed: Q12.3 (D), R12.2
unnamed: Q13.3 (D), R13.2
unnamed: Q14.3 (D), R14.2
unnamed: Q15.3 (D), R15.2
unnamed: Q16.3 (D), R16.2
unnamed: Q17.3 (D), R17.2
unnamed: Q18.3 (D), R18.2
unnamed: Q19.3 (D), R19.2
unnamed: Q20.3 (D), R20.2
unnamed: Q21.3 (D), R21.2
unnamed: Q22.3 (D), R22.2
unnamed: Q23.3 (D), R23.2
unnamed: Q24.3 (D), R24.2
P0: J1.38 (P1_0), Q31.3 (D), TP36.1, U4.6 (3A)
P1: J1.39 (P1_1), Q25.3 (D), TP37.1, U4.1 (1A)
P2: J1.36 (P1_2), Q26.3 (D), TP34.1, U5.1 (1A)
P3: J1.37 (P1_3), Q29.3 (D), TP35.1, U5.3 (2A)
P4: J1.34 (P1_4), Q30.3 (D), TP32.1, U6.3 (2A)
P5: J1.35 (P1_5), Q32.3 (D), TP33.1, U5.6 (3A)
P6: J1.32 (P1_6), Q33.3 (D), TP30.1, U6.6 (3A)
P7: J1.33 (P1_7), Q27.3 (D), TP31.1, U6.1 (1A)
PHI2: J1.24 (PHI2), TP27.1, U8.9
R/W: J1.2 (R/W), TP9.1, U2.1 (A->B), U7.12
_A0: J2.9 (A45), U3.6
_A1: J2.10 (A46), U3.3
_A2: J2.11 (A6), U3.11
_A3: J2.12 (A5), U3.8
_AUDIO1_0: J2.61 (B33), Q6.1 (G)
_AUDIO1_1: J2.62 (B34), Q5.1 (G)
_AUDIO1_2: J2.63 (B18), Q4.1 (G)
_AUDIO1_3: J2.64 (B17), Q3.1 (G)
_AUDIO1_4: J2.65 (B30), Q2.1 (G)
_AUDIO1_5: J2.66 (B31), Q1.1 (G)
_AUDIO2_0: J2.45 (B45), Q12.1 (G)
_AUDIO2_1: J2.46 (B46), Q11.1 (G)
_AUDIO2_2: J2.47 (B6), Q10.1 (G)
_AUDIO2_3: J2.48 (B5), Q9.1 (G)
_AUDIO2_4: J2.49 (B42), Q8.1 (G)
_AUDIO2_5: J2.50 (B43), Q7.1 (G)
_AUDIO3_0: J2.51 (B9), Q18.1 (G)
_AUDIO3_1: J2.52 (B8), Q17.1 (G)
_AUDIO3_2: J2.53 (B39), Q16.1 (G)
_AUDIO3_3: J2.54 (B40), Q15.1 (G)
_AUDIO3_4: J2.55 (B12), Q14.1 (G)
_AUDIO3_5: J2.56 (B11), Q13.1 (G)
_AUDIO4_0: J2.67 (B21), Q24.1 (G)
_AUDIO4_1: J2.68 (B20), Q23.1 (G)
_AUDIO4_2: J2.69 (B27), Q22.1 (G)
_AUDIO4_3: J2.70 (B28), Q21.1 (G)
_AUDIO4_4: J2.71 (B24), Q20.1 (G)
_AUDIO4_5: J2.72 (B23), Q19.1 (G)
_D0: J2.32 (A20), U2.9 (A7)
_D1: J2.31 (A21), U2.8 (A6)
_D2: J2.29 (A30), U2.7 (A5)
_D3: J2.30 (A31), U2.6 (A4)
_D4: J2.33 (A27), U2.5 (A3)
_D5: J2.34 (A28), U2.4 (A2)
_D6: J2.35 (A24), U2.3 (A1)
_D7: J2.36 (A23), U2.2 (A0)
_DUMP: J2.17 (A39), Q25.1 (G), Q26.1 (G), Q27.1 (G), Q29.1 (G), Q30.1 (G), Q31.1 (G), Q32.1 (G), Q33.1 (G)
_P0: J2.7 (A3), U4.2 (3Y)
_P1: J2.8 (A2), U4.7 (1Y)
_P2: J2.13 (A42), U5.7 (1Y)
_P3: J2.14 (A43), U5.5 (2Y)
_P4: J2.25 (A33), U6.5 (2Y)
_P5: J2.15 (A9), U5.2 (3Y)
_P6: J2.26 (A34), U6.2 (3Y)
_P7: J2.27 (A18), U6.7 (1Y)
_PHI2: J2.44 (B2), U8.8
_R/W: J2.5 (A48), U7.11
~CS1: J1.1 (~CS1), TP8.1, U7.2
~CS2: J1.22 (~CS2), TP25.1, U8.5
~CS3: J1.11 (~CS3), TP17.1, U8.12
~CS4: J1.19 (~CS4), TP23.1, U8.2
~_CS1: J2.6 (A49), U7.3
~_CS2: J2.59 (B15), U8.6
~_CS3: J2.58 (B37), U8.11
~_CS4: J2.60 (B14), U8.3
~_EN: J2.43 (B3), U2.19 (CE)
