nmikstas/atari_pokey/PCB/Prototype1/Prototype1.kicad_pcb

## KiCad design PCB/Prototype1/Prototype1.kicad_pcb (2024-09-08, an earlier design)

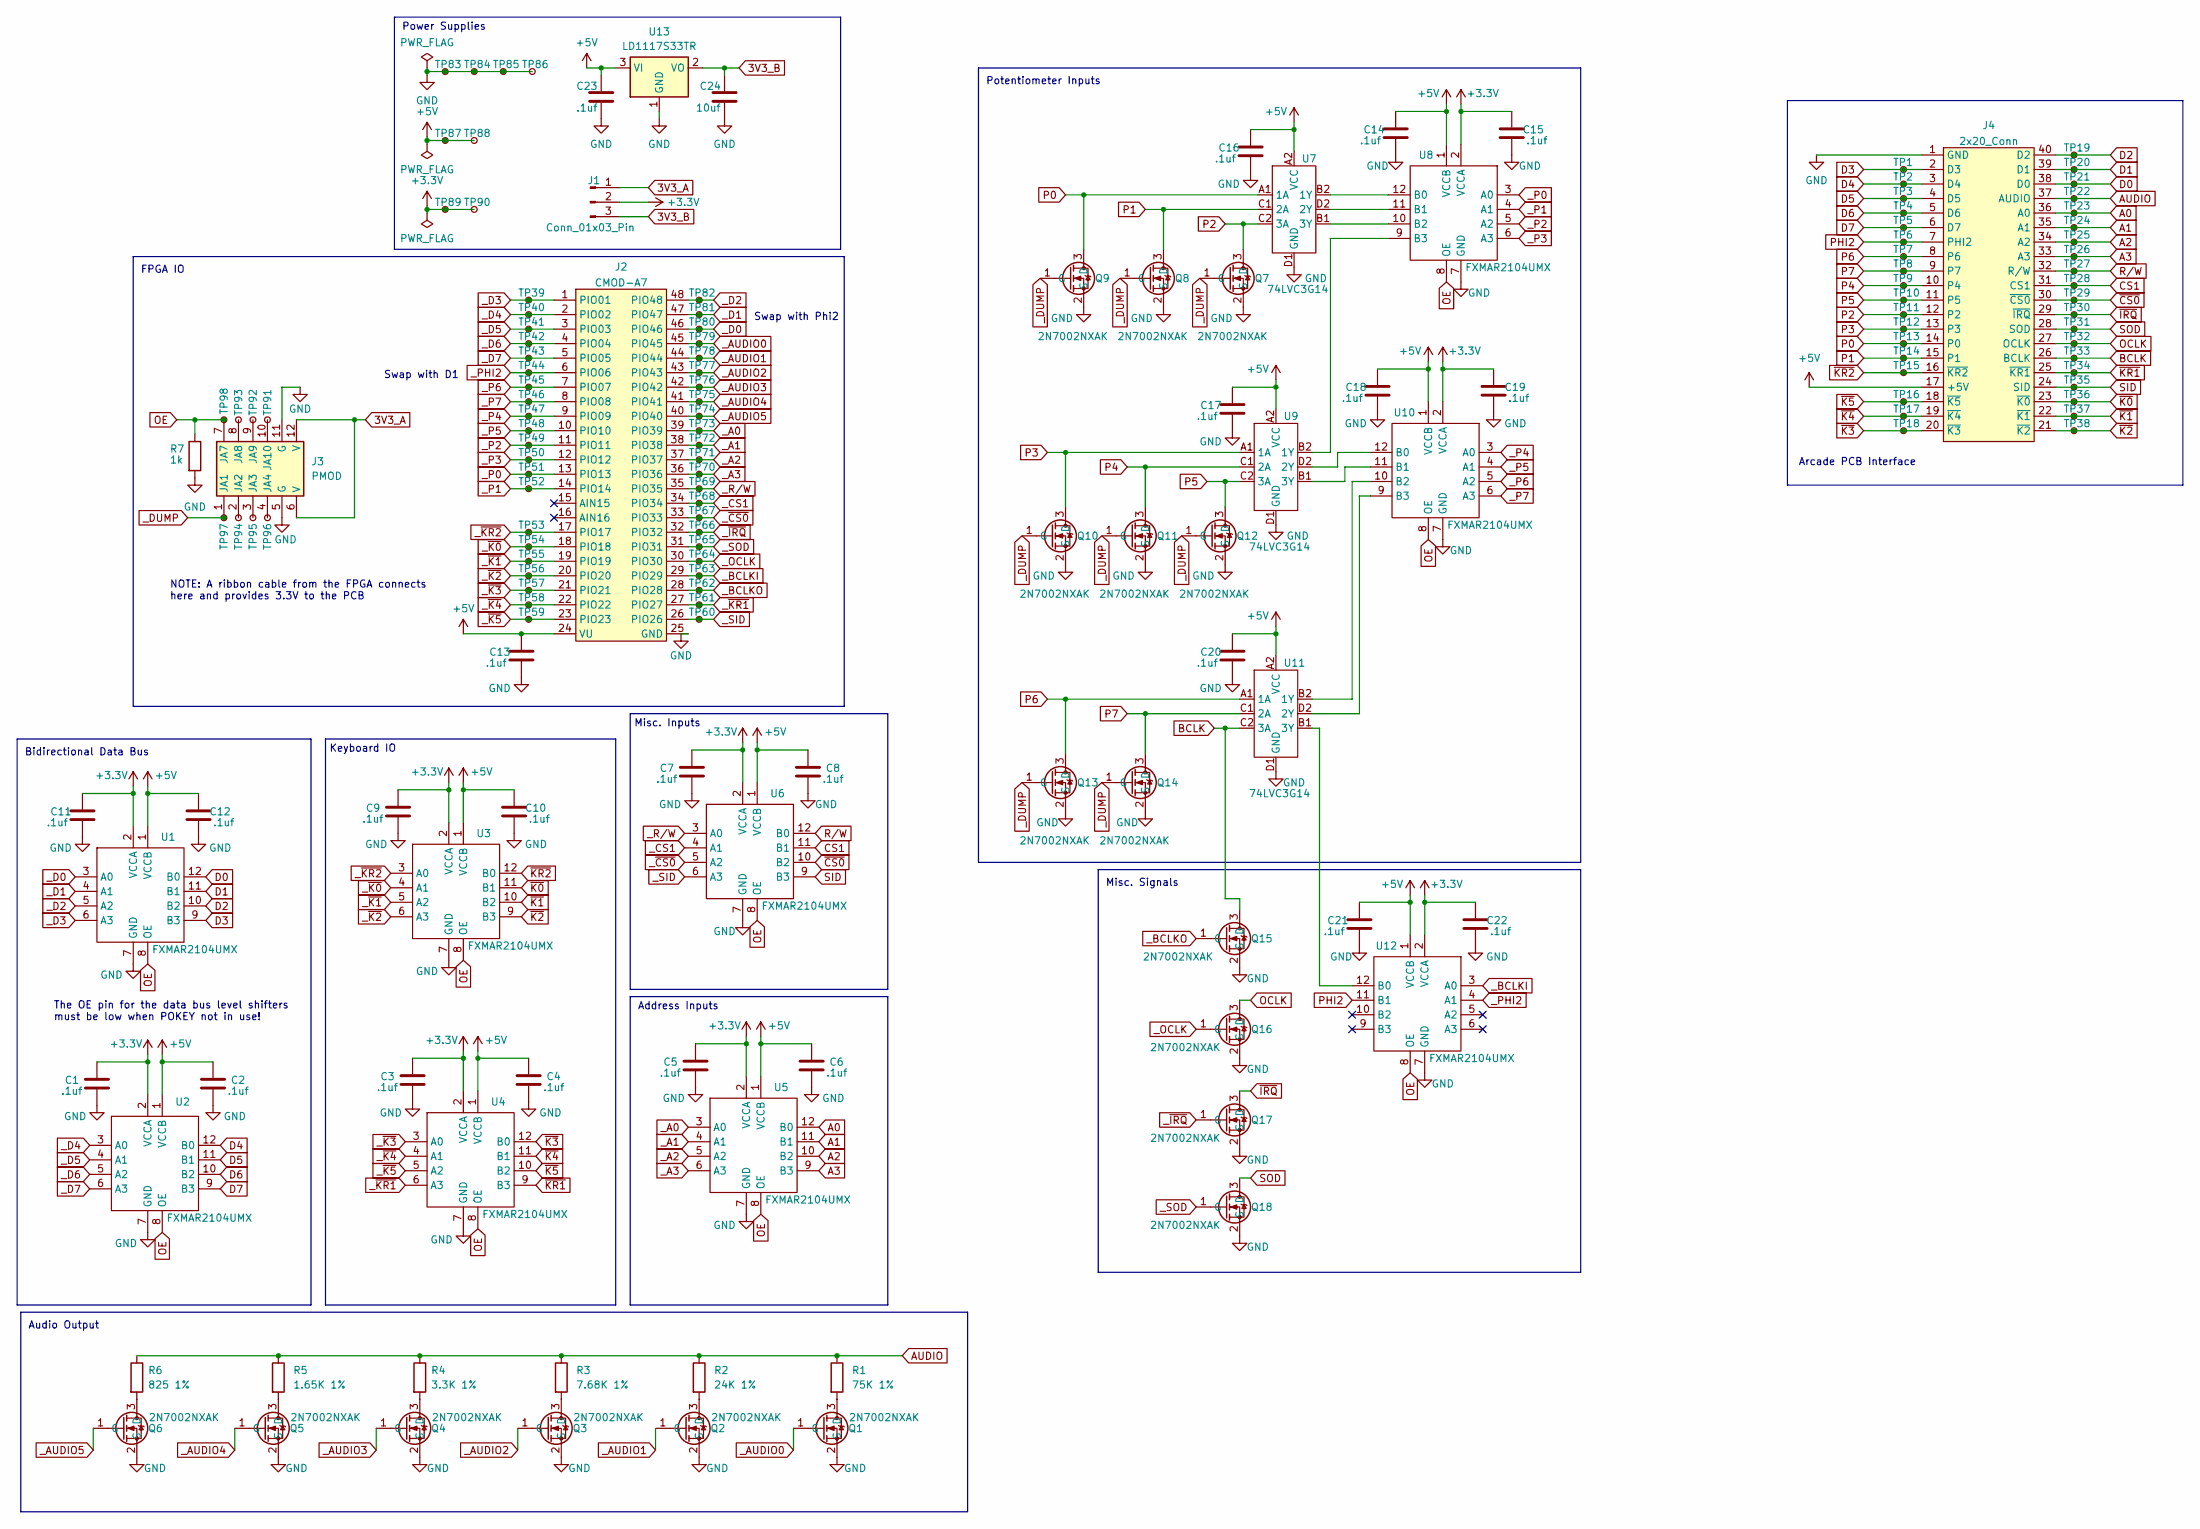
[picture p11: schematic Prototype1.kicad_sch]

Parts:
C1, C2, C3, C4, C5, C6, C7, C8, C9, C10, C11, C12, C13, C14, C15, C16, C17, C18, C19, C20, C21, C22, C23: .1uf; C_0402_1005Metric
C24: 10uf; C_0805_2012Metric
J1: Conn_01x03_Pin; PinSocket_1x03_P2.54mm_Vertical
J2: CMOD-A7; Con_2X24
J3: PMOD
J4: 2x20_Conn; Con_2X20
Q1, Q2, Q3, Q4, Q5, Q6, Q7, Q8, Q9, Q10, Q11, Q12, Q13, Q14, Q15, Q16, Q17, Q18: 2N7002NXAK; SOT-23-3
R1: 75K 1%; R_0402_1005Metric
R2: 24K 1%; R_0402_1005Metric
R3: 7.68K 1%; R_0402_1005Metric
R4: 3.3K 1%; R_0402_1005Metric
R5: 1.65K 1%; R_0402_1005Metric
R6: 825 1%; R_0402_1005Metric
R7: 1k; R_0402_1005Metric
TP1, TP2, TP3, TP4, TP5, TP6, TP7, TP8, TP9, TP10, TP11, TP12, TP13, TP14, TP15, TP16, TP17, TP18, TP19, TP20, TP21, TP22, TP23, TP24, TP25, TP26, TP27, TP28, TP29, TP30, TP31, TP32, TP33, TP34, TP35, TP36, TP37, TP38, TP39, TP40, TP41, TP42, TP43, TP44, TP45, TP46, TP47, TP48, TP49, TP50, TP51, TP52, TP53, TP54, TP55, TP56, TP57, TP58, TP59, TP60, TP61, TP62, TP63, TP64, TP65, TP66, TP67, TP68, TP69, TP70, TP71, TP72, TP73, TP74, TP75, TP76, TP77, TP78, TP79, TP80, TP81, TP82, TP83, TP84, TP85, TP86, TP87, TP88, TP89, TP90, TP91, TP92, TP93, TP94, TP95, TP96, TP97, TP98: TP
U1, U2, U3, U4, U5, U6, U8, U10, U12: FXMAR2104UMX; ULTRATHIN_MLP_12L_ONS-L
U7, U9, U11: 74LVC3G14; YZP8
U13: LD1117S33TR; Reg

Connections:
3V3_A: J1.1, J3.6 (V), J3.12 (V)
3V3_B: C24.1, J1.3, U13.2 (VO)
+3.3V: C1.1, C3.1, C5.1, C7.1, C9.1, C11.1, C15.1, C19.1, C22.1, J1.2, TP89.1, TP90.1, U1.2 (VCCA), U2.2 (VCCA), U3.2 (VCCA), U4.2 (VCCA), U5.2 (VCCA), U6.2 (VCCA), U8.2 (VCCA), U10.2 (VCCA), U12.2 (VCCA)
+5V: C2.1, C4.1, C6.1, C8.1, C10.1, C12.1, C13.1, C14.1, C16.1, C17.1, C18.1, C20.1, C21.1, C23.1, J2.24 (VU), J4.17 (+5V), TP87.1, TP88.1, U1.1 (VCCB), U2.1 (VCCB), U3.1 (VCCB), U4.1 (VCCB), U5.1 (VCCB), U6.1 (VCCB), U7.A2 (VCC), U8.1 (VCCB), U9.A2 (VCC), U10.1 (VCCB), U11.A2 (VCC), U12.1 (VCCB), U13.3 (VI)
A0: J4.36 (A0), TP23.1, U5.12 (B0)
A1: J4.35 (A1), TP24.1, U5.11 (B1)
A2: J4.34 (A2), TP25.1, U5.10 (B2)
A3: J4.33 (A3), TP26.1, U5.9 (B3)
AUDIO: J4.37 (AUDIO), R1.1, R2.1, R3.1, R4.1, R5.1, R6.1, TP22.1
BCLK: J4.26 (BCLK), Q15.3 (D), TP33.1, U11.C2 (3A)
CS1: J4.31 (CS1), TP28.1, U6.11 (B1)
D0: J4.38 (D0), TP21.1, U1.12 (B0)
D1: J4.39 (D1), TP20.1, U1.11 (B1)
D2: J4.40 (D2), TP19.1, U1.10 (B2)
D3: J4.2 (D3), TP1.1, U1.9 (B3)
D4: J4.3 (D4), TP2.1, U2.12 (B0)
D5: J4.4 (D5), TP3.1, U2.11 (B1)
D6: J4.5 (D6), TP4.1, U2.10 (B2)
D7: J4.6 (D7), TP5.1, U2.9 (B3)
GND: C1.2, C2.2, C3.2, C4.2, C5.2, C6.2, C7.2, C8.2, C9.2, C10.2, C11.2, C12.2, C13.2, C14.2, C15.2, C16.2, C17.2, C18.2, C19.2, C20.2, C21.2, C22.2, C23.2, C24.2, J2.25 (GND), J3.5 (G), J3.11 (G), J4.1 (GND), Q1.2 (S), Q2.2 (S), Q3.2 (S), Q4.2 (S), Q5.2 (S), Q6.2 (S), Q7.2 (S), Q8.2 (S), Q9.2 (S), Q10.2 (S), Q11.2 (S), Q12.2 (S), Q13.2 (S), Q14.2 (S), Q15.2 (S), Q16.2 (S), Q17.2 (S), Q18.2 (S), R7.2, TP83.1, TP84.1, TP85.1, TP86.1, U1.7 (GND), U2.7 (GND), U3.7 (GND), U4.7 (GND), U5.7 (GND), U6.7 (GND), U7.D1 (GND), U8.7 (GND), U9.D1 (GND), U10.7 (GND), U11.D1 (GND), U12.7 (GND), U13.1 (GND)
unnamed: J3.2 (JA2), TP94.1
unnamed: J3.3 (JA3), TP95.1
unnamed: J3.4 (JA4), TP96.1
unnamed: J3.8 (JA8), TP93.1
unnamed: J3.9 (JA9), TP92.1
unnamed: J3.10 (JA10), TP91.1
unnamed: Q1.3 (D), R1.2
unnamed: Q2.3 (D), R2.2
unnamed: Q3.3 (D), R3.2
unnamed: Q4.3 (D), R4.2
unnamed: Q5.3 (D), R5.2
unnamed: Q6.3 (D), R6.2
unnamed: U7.B2 (1Y), U8.12 (B0)
unnamed: U7.D2 (2Y), U8.11 (B1)
unnamed: U7.B1 (3Y), U8.10 (B2)
unnamed: U8.9 (B3), U9.B2 (1Y)
unnamed: U9.D2 (2Y), U10.12 (B0)
unnamed: U9.B1 (3Y), U10.11 (B1)
unnamed: U10.10 (B2), U11.B2 (1Y)
unnamed: U10.9 (B3), U11.D2 (2Y)
unnamed: U11.B1 (3Y), U12.12 (B0)
OCLK: J4.27 (OCLK), Q16.3 (D), TP32.1
OE: J3.7 (JA7), R7.1, TP98.1, U1.8 (OE), U2.8 (OE), U3.8 (OE), U4.8 (OE), U5.8 (OE), U6.8 (OE), U8.8 (OE), U10.8 (OE), U12.8 (OE)
P0: J4.14 (P0), Q9.3 (D), TP13.1, U7.A1 (1A)
P1: J4.15 (P1), Q8.3 (D), TP14.1, U7.C1 (2A)
P2: J4.12 (P2), Q7.3 (D), TP11.1, U7.C2 (3A)
P3: J4.13 (P3), Q10.3 (D), TP12.1, U9.A1 (1A)
P4: J4.10 (P4), Q11.3 (D), TP9.1, U9.C1 (2A)
P5: J4.11 (P5), Q12.3 (D), TP10.1, U9.C2 (3A)
P6: J4.8 (P6), Q13.3 (D), TP7.1, U11.A1 (1A)
P7: J4.9 (P7), Q14.3 (D), TP8.1, U11.C1 (2A)
PHI2: J4.7 (PHI2), TP6.1, U12.11 (B1)
R/W: J4.32 (R/W), TP27.1, U6.12 (B0)
SID: J4.24 (SID), TP35.1, U6.9 (B3)
SOD: J4.28 (SOD), Q18.3 (D), TP31.1
_A0: J2.39 (PIO39), TP73.1, U5.3 (A0)
_A1: J2.38 (PIO38), TP72.1, U5.4 (A1)
_A2: J2.37 (PIO37), TP71.1, U5.5 (A2)
_A3: J2.36 (PIO36), TP70.1, U5.6 (A3)
_AUDIO0: J2.45 (PIO45), Q1.1 (G), TP79.1
_AUDIO1: J2.44 (PIO44), Q2.1 (G), TP78.1
_AUDIO2: J2.43 (PIO43), Q3.1 (G), TP77.1
_AUDIO3: J2.42 (PIO42), Q4.1 (G), TP76.1
_AUDIO4: J2.41 (PIO41), Q5.1 (G), TP75.1
_AUDIO5: J2.40 (PIO40), Q6.1 (G), TP74.1
_BCLKI: J2.29 (PIO29), TP63.1, U12.3 (A0)
_BCLKO: J2.28 (PIO28), Q15.1 (G), TP62.1
_CS1: J2.34 (PIO34), TP68.1, U6.4 (A1)
_D0: J2.46 (PIO46), TP80.1, U1.3 (A0)
_D1: J2.47 (PIO47), TP81.1, U1.4 (A1)
_D2: J2.48 (PIO48), TP82.1, U1.5 (A2)
_D3: J2.1 (PIO01), TP39.1, U1.6 (A3)
_D4: J2.2 (PIO02), TP40.1, U2.3 (A0)
_D5: J2.3 (PIO03), TP41.1, U2.4 (A1)
_D6: J2.4 (PIO04), TP42.1, U2.5 (A2)
_D7: J2.5 (PIO05), TP43.1, U2.6 (A3)
_DUMP: J3.1 (JA1), Q7.1 (G), Q8.1 (G), Q9.1 (G), Q10.1 (G), Q11.1 (G), Q12.1 (G), Q13.1 (G), Q14.1 (G), TP97.1
_OCLK: J2.30 (PIO30), Q16.1 (G), TP64.1
_P0: J2.13 (PIO13), TP51.1, U8.3 (A0)
_P1: J2.14 (PIO14), TP52.1, U8.4 (A1)
_P2: J2.11 (PIO11), TP49.1, U8.5 (A2)
_P3: J2.12 (PIO12), TP50.1, U8.6 (A3)
_P4: J2.9 (PIO09), TP47.1, U10.3 (A0)
_P5: J2.10 (PIO10), TP48.1, U10.4 (A1)
_P6: J2.7 (PIO07), TP45.1, U10.5 (A2)
_P7: J2.8 (PIO08), TP46.1, U10.6 (A3)
_PHI2: J2.6 (PIO06), TP44.1, U12.4 (A1)
_R/W: J2.35 (PIO35), TP69.1, U6.3 (A0)
_SID: J2.26 (PIO26), TP60.1, U6.6 (A3)
_SOD: J2.31 (PIO31), Q18.1 (G), TP65.1
_~CS0: J2.33 (PIO33), TP67.1, U6.5 (A2)
_~IRQ: J2.32 (PIO32), Q17.1 (G), TP66.1
_~K0: J2.18 (PIO18), TP54.1, U3.4 (A1)
_~K1: J2.19 (PIO19), TP55.1, U3.5 (A2)
_~K2: J2.20 (PIO20), TP56.1, U3.6 (A3)
_~K3: J2.21 (PIO21), TP57.1, U4.3 (A0)
_~K4: J2.22 (PIO22), TP58.1, U4.4 (A1)
_~K5: J2.23 (PIO23), TP59.1, U4.5 (A2)
_~KR1: J2.27 (PIO27), TP61.1, U4.6 (A3)
_~KR2: J2.17 (PIO17), TP53.1, U3.3 (A0)
~CS0: J4.30 (~CS0), TP29.1, U6.10 (B2)
~IRQ: J4.29 (~IRQ), Q17.3 (D), TP30.1
~K0: J4.23 (~K0), TP36.1, U3.11 (B1)
~K1: J4.22 (~K1), TP37.1, U3.10 (B2)
~K2: J4.21 (~K2), TP38.1, U3.9 (B3)
~K3: J4.20 (~K3), TP18.1, U4.12 (B0)
~K4: J4.19 (~K4), TP17.1, U4.11 (B1)
~K5: J4.18 (~K5), TP16.1, U4.10 (B2)
~KR1: J4.25 (~KR1), TP34.1, U4.9 (B3)
~KR2: J4.16 (~KR2), TP15.1, U3.12 (B0)

Notes on the sheet:
Arcade PCB Interface
Bidirectional Data Bus
Address Inputs
Misc. Signals
Potentiometer Inputs
The OE pin for the data bus level shifters must be low when POKEY not in use!
Misc. Inputs
Keyboard IO
FPGA IO
Swap with D1
NOTE: A ribbon cable from the FPGA connects here and provides 3.3V to the PCB
Audio Output
Swap with Phi2
Power Supplies

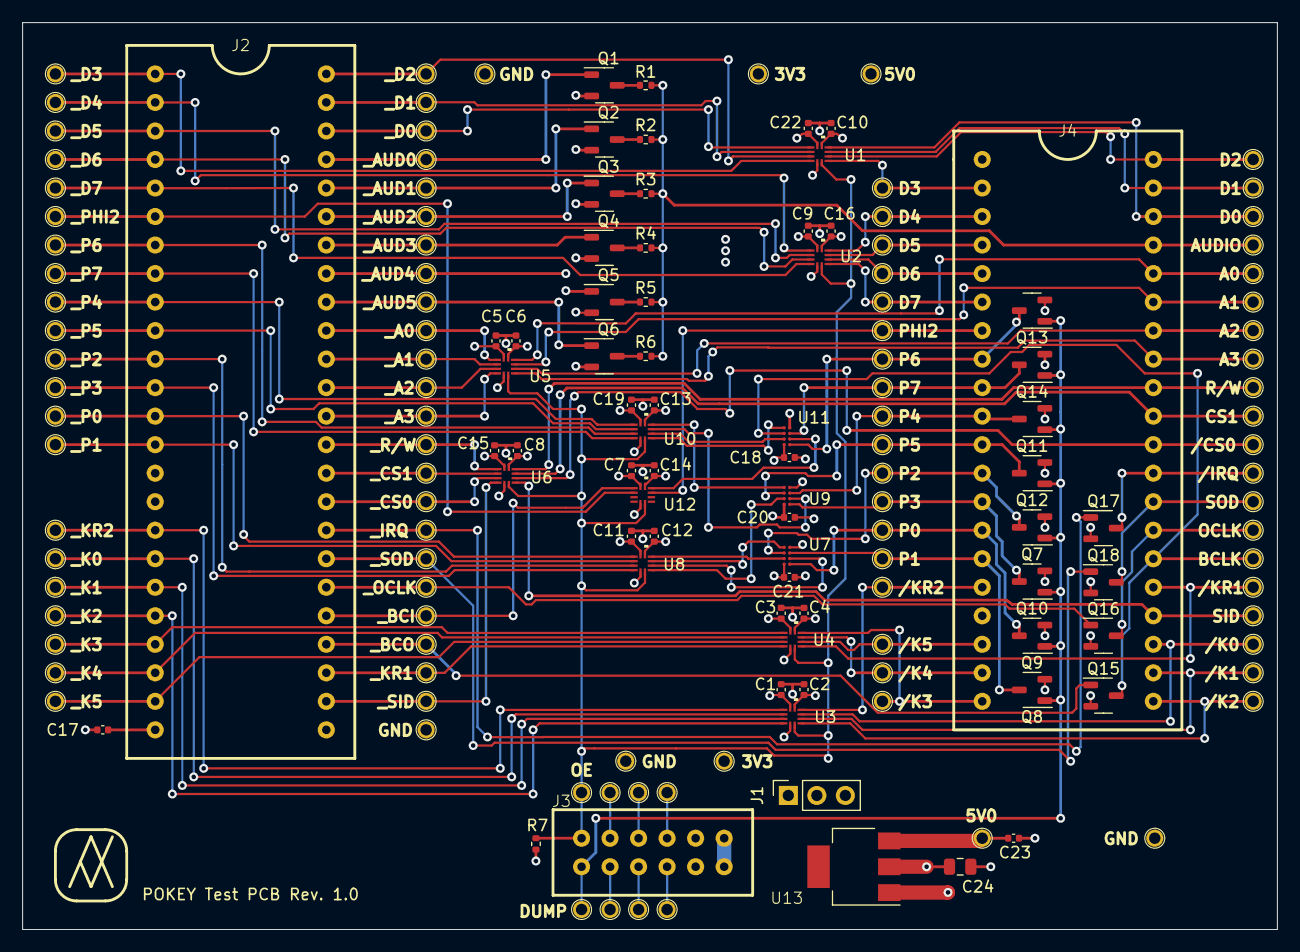
[picture p12: board Prototype1.kicad_pcb from above]

Board: 4 copper layers, 111.8 x 80.8 mm, 164 parts (0 on the bottom side), 110 nets.
