nmikstas/atari_pokey/PCB/Through_Hole_Quad_Xilinx/Through_Hole_Quad_Xilinx.kicad_pcb

## KiCad design PCB/Through_Hole_Quad_Xilinx/Through_Hole_Quad_Xilinx.kicad_pcb (2024-11-11)

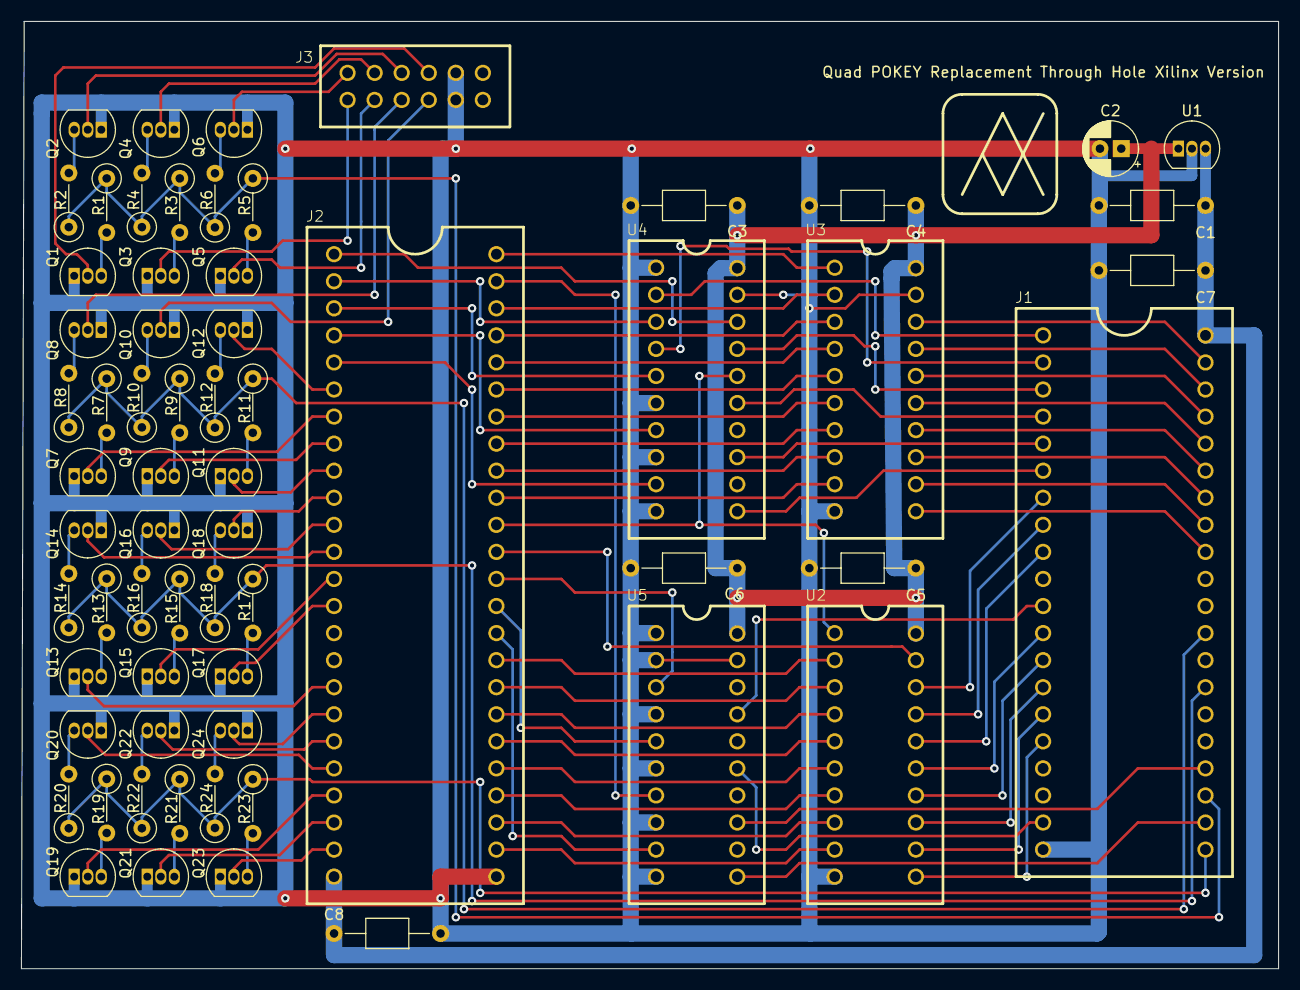
[picture p13: board Through_Hole_Quad_Xilinx.kicad_pcb from above]

Board: 2 copper layers, 118.0 x 88.9 mm, 64 parts (0 on the bottom side), 109 nets.

Parts:
C1, C3, C4, C5, C6, C7, C8: .1uf; C_Axial_L3.8mm_D2.6mm_P10.00mm_Horizontal
C2: 10uf; CP_Radial_D5.0mm_P2.00mm
J1: Con_2X20
J2: CMOD-A7; Con_2X24
J3: PMOD
Q1, Q2, Q3, Q4, Q5, Q6, Q7, Q8, Q9, Q10, Q11, Q12, Q13, Q14, Q15, Q16, Q17, Q18, Q19, Q20, Q21, Q22, Q23, Q24: TN2106; TO-92_Inline
R1, R7, R13, R19: 825 1%; R_Axial_DIN0207_L6.3mm_D2.5mm_P5.08mm_Vertical
R2, R8, R14, R20: 1.65K 1%; R_Axial_DIN0207_L6.3mm_D2.5mm_P5.08mm_Vertical
R3, R9, R15, R21: 3.3K 1%; R_Axial_DIN0207_L6.3mm_D2.5mm_P5.08mm_Vertical
R4, R10, R16, R22: 7.68K 1%; R_Axial_DIN0207_L6.3mm_D2.5mm_P5.08mm_Vertical
R5, R11, R17, R23: 24K 1%; R_Axial_DIN0207_L6.3mm_D2.5mm_P5.08mm_Vertical
R6, R12, R18, R24: 75K 1%; R_Axial_DIN0207_L6.3mm_D2.5mm_P5.08mm_Vertical
U1: L78L05_TO92; TO-92_Inline
U2, U3, U4, U5: DIP_20

Connections:
+3.3V: C2.1, C3.1, C4.1, C5.1, C6.1, U1.1 (VO), U2.20 (VCC), U3.20 (VCC), U4.20 (VCC), U5.20 (VCC)
+5V: C1.1, C7.1, C8.1, J1.40 (VCC), J2.24 (VU), U1.3 (VI)
A0: J1.6 (A0), U4.11 (2A1)
A1: J1.5 (A1), U4.13 (2A2)
A2: J1.4 (A2), U4.15 (2A3)
A3: J1.3 (A3), U4.17 (2A4)
AUDIO1: J1.23 (OUT1), R1.1, R2.1, R3.1, R4.1, R5.1, R6.1
AUDIO2: J1.29 (OUT2), R7.1, R8.1, R9.1, R10.1, R11.1, R12.1
AUDIO3: J1.27 (OUT3), R13.1, R14.1, R15.1, R16.1, R17.1, R18.1
AUDIO4: J1.21 (OUT4), R19.1, R20.1, R21.1, R22.1, R23.1, R24.1
D0: J1.7 (D0), U2.18 (B0)
D1: J1.8 (D1), U2.17 (B1)
D2: J1.9 (D2), U2.16 (B2)
D3: J1.12 (D3), U2.15 (B3)
D4: J1.13 (D4), U2.14 (B4)
D5: J1.14 (D5), U2.13 (B5)
D6: J1.15 (D6), U2.12 (B6)
D7: J1.16 (D7), U2.11 (B7)
GND: C1.2, C2.2, C3.2, C4.2, C5.2, C6.2, C7.2, C8.2, J1.20 (GND), J2.25 (GND), J3.5 (G), J3.11 (G), Q1.1 (S), Q2.1 (S), Q3.1 (S), Q4.1 (S), Q5.1 (S), Q6.1 (S), Q7.1 (S), Q8.1 (S), Q9.1 (S), Q10.1 (S), Q11.1 (S), Q12.1 (S), Q13.1 (S), Q14.1 (S), Q15.1 (S), Q16.1 (S), Q17.1 (S), Q18.1 (S), Q19.1 (S), Q20.1 (S), Q21.1 (S), Q22.1 (S), Q23.1 (S), Q24.1 (S), U1.2 (GND), U2.10 (GND), U3.10 (GND), U3.19 (CE), U4.1 (1~OE), U4.6 (1A3), U4.8 (1A4), U4.10 (GND), U4.19 (2~OE), U5.1 (1~OE), U5.2 (1A1), U5.4 (1A2), U5.6 (1A3), U5.8 (1A4), U5.10 (GND), U5.19 (2~OE)
unnamed: Q1.3 (D), R1.2
unnamed: Q2.3 (D), R2.2
unnamed: Q3.3 (D), R3.2
unnamed: Q4.3 (D), R4.2
unnamed: Q5.3 (D), R5.2
unnamed: Q6.3 (D), R6.2
unnamed: Q7.3 (D), R7.2
unnamed: Q8.3 (D), R8.2
unnamed: Q9.3 (D), R9.2
unnamed: Q10.3 (D), R10.2
unnamed: Q11.3 (D), R11.2
unnamed: Q12.3 (D), R12.2
unnamed: Q13.3 (D), R13.2
unnamed: Q14.3 (D), R14.2
unnamed: Q15.3 (D), R15.2
unnamed: Q16.3 (D), R16.2
unnamed: Q17.3 (D), R17.2
unnamed: Q18.3 (D), R18.2
unnamed: Q19.3 (D), R19.2
unnamed: Q20.3 (D), R20.2
unnamed: Q21.3 (D), R21.2
unnamed: Q22.3 (D), R22.2
unnamed: Q23.3 (D), R23.2
unnamed: Q24.3 (D), R24.2
P0: J1.38 (P1_0), U3.17 (B1)
P1: J1.39 (P1_1), U3.18 (B0)
P2: J1.36 (P1_2), U3.15 (B3)
P3: J1.37 (P1_3), U3.16 (B2)
P4: J1.34 (P1_4), U3.13 (B5)
P5: J1.35 (P1_5), U3.14 (B4)
P6: J1.32 (P1_6), U3.11 (B7)
P7: J1.33 (P1_7), U3.12 (B6)
PHI2: J1.24 (PHI2), U5.13 (2A2)
R/W: J1.2 (R/W), U4.4 (1A2)
_A0: J2.5 (PIO05), U4.9 (2Y1)
_A1: J2.4 (PIO04), U4.7 (2Y2)
_A2: J2.3 (PIO03), U4.5 (2Y3)
_A3: J2.2 (PIO02), U4.3 (2Y4)
_AUDIO1_0: J3.7 (JA7), Q6.2 (G)
_AUDIO1_1: J3.2 (JA2), Q5.2 (G)
_AUDIO1_2: J3.8 (JA8), Q4.2 (G)
_AUDIO1_3: J3.1 (JA1), Q3.2 (G)
_AUDIO1_4: J3.9 (JA9), Q2.2 (G)
_AUDIO1_5: J3.10 (JA10), Q1.2 (G)
_AUDIO2_0: J2.6 (PIO06), Q12.2 (G)
_AUDIO2_1: J2.9 (PIO09), Q11.2 (G)
_AUDIO2_2: J3.4 (JA4), Q10.2 (G)
_AUDIO2_3: J2.8 (PIO08), Q9.2 (G)
_AUDIO2_4: J3.3 (JA3), Q8.2 (G)
_AUDIO2_5: J2.7 (PIO07), Q7.2 (G)
_AUDIO3_0: J2.10 (PIO10), Q18.2 (G)
_AUDIO3_1: J2.14 (PIO14), Q17.2 (G)
_AUDIO3_2: J2.11 (PIO11), Q16.2 (G)
_AUDIO3_3: J2.13 (PIO13), Q15.2 (G)
_AUDIO3_4: J2.12 (PIO12), Q14.2 (G)
_AUDIO3_5: J2.17 (PIO17), Q13.2 (G)
_AUDIO4_0: J2.18 (PIO18), Q24.2 (G)
_AUDIO4_1: J2.23 (PIO23), Q23.2 (G)
_AUDIO4_2: J2.19 (PIO19), Q22.2 (G)
_AUDIO4_3: J2.22 (PIO22), Q21.2 (G)
_AUDIO4_4: J2.20 (PIO20), Q20.2 (G)
_AUDIO4_5: J2.21 (PIO21), Q19.2 (G)
_D0: J2.33 (PIO33), U2.2 (A0)
_D1: J2.32 (PIO32), U2.3 (A1)
_D2: J2.31 (PIO31), U2.4 (A2)
_D3: J2.30 (PIO30), U2.5 (A3)
_D4: J2.29 (PIO29), U2.6 (A4)
_D5: J2.28 (PIO28), U2.7 (A5)
_D6: J2.27 (PIO27), U2.8 (A6)
_D7: J2.26 (PIO26), U2.9 (A7)
_DUMP: J2.48 (PIO48), U3.1 (A->B)
_P0: J2.45 (PIO45), U3.3 (A1)
_P1: J2.46 (PIO46), U3.2 (A0)
_P2: J2.43 (PIO43), U3.5 (A3)
_P3: J2.44 (PIO44), U3.4 (A2)
_P4: J2.41 (PIO41), U3.7 (A5)
_P5: J2.42 (PIO42), U3.6 (A4)
_P6: J2.39 (PIO39), U3.9 (A7)
_P7: J2.40 (PIO40), U3.8 (A6)
_PHI2: J2.47 (PIO47), U5.7 (2Y2)
_R/W: J2.38 (PIO38), U2.1 (A->B), U4.16 (1Y2)
_~CS1: J2.1 (PIO01), U4.18 (1Y1)
_~CS2: J2.34 (PIO34), U5.9 (2Y1)
_~CS3: J2.36 (PIO36), U5.3 (2Y4)
_~CS4: J2.35 (PIO35), U5.5 (2Y3)
~CS1: J1.1 (~CS1), U4.2 (1A1)
~CS2: J1.22 (~CS2), U5.11 (2A1)
~CS3: J1.11 (~CS3), U5.17 (2A4)
~CS4: J1.19 (~CS4), U5.15 (2A3)
~_EN: J2.37 (PIO37), U2.19 (CE)
