nmikstas/atari_pokey/HDL/VHDL/SER_core/tb_SER_core.vhd

--Test bench for the POKEY serial clock generator.
--Written by Nick Mikstas

library ieee;
use ieee.std_logic_1164.all;
use ieee.numeric_std.all;

entity tb_SER_core is
end tb_SER_core;

architecture behavioral of tb_SER_core is

    constant CLK179MHZ_PERIOD : time := 558.7247666 ns;

    --Frequency control signals.
    signal clk            : std_logic := '0';
    signal D              : std_logic_vector(7 downto 0) := "00000000";
    signal Addr0w         : std_logic := '0';
    signal Addr2w         : std_logic := '0';
    signal Addr4w         : std_logic := '0';
    signal Addr6w         : std_logic := '0';
    signal Addr9w         : std_logic := '0';
    signal enFastClk1     : std_logic := '0';
    signal enFastClk3     : std_logic := '1';
    signal ch2Bits16      : std_logic := '0';
    signal ch4Bits16      : std_logic := '1';
    signal resyncSerClk   : std_logic;
    signal Timer          : std_logic_vector(4 downto 1);
    signal nTimer         : std_logic_vector(4 downto 1);
    signal rstAudPhase    : std_logic;
    signal resyncTwoTones : std_logic;

    --Clock pulse generator signals.
    signal init     : std_logic := '0';
    signal sel15Khz : std_logic := '0';
    signal audClock : std_logic;
    signal keybClk  : std_logic;

    --Serial clock generator signals.
    signal SKCTLS       : std_logic_vector(6 downto 4) := "000";
    signal BCLK_in      : std_logic := '0';
    signal BCLK_out     : std_logic;
    signal sdiClock     : std_logic;
    signal sdoClock     : std_logic;
    signal OCLK         : std_logic;

    --SEROUT signals.
    signal AddrDw         : std_logic := '0';
    signal SKCTLS3        : std_logic := '0';
    signal SKCTLS7        : std_logic := '0';
    signal setSdoComplete : std_logic;
    signal sdoFinish      : std_logic;
    signal SOD            : std_logic;

    --SERIN signals.
    signal SID         : std_logic := '1';
    signal siDelay     : std_logic;
    signal setFramerr  : std_logic;
    signal setSdiCompl : std_logic;
    signal sdiBusy     : std_logic;
    signal serialByte  : std_logic_vector(7 downto 0);    

    --BCLK_in clock signal.
    signal counter : unsigned(2 downto 0) := "000";

begin
    clk <= NOT clk after CLK179MHZ_PERIOD / 2;

    --Audio clock generator.
    clock_gen_core_0 : entity work.clock_gen_core
    port map
    (
        clk      => clk,
        init     => init,
        sel15Khz => sel15Khz,
        audClock => audClock,
        keybClk  => keybClk
    );     

    --Audio frequency control.
    aud_freq_control_0 : entity work.aud_freq_control
    port map
    ( 
        clk            => clk,
        audClock       => audClock,
        D              => D,
        Addr0w         => Addr0w,
        Addr2w         => Addr2w,
        Addr4w         => Addr4w,
        Addr6w         => Addr6w,
        Addr9w         => Addr9w,
        enFastClk1     => enFastClk1,
        enFastClk3     => enFastClk3,
        ch2Bits16      => ch2Bits16,
        ch4Bits16      => ch4Bits16,
        resyncTwoTones => resyncTwoTones,
        resyncSerClk   => resyncSerClk,
        Timer          => Timer,
        nTimer         => nTimer,
        rstAudPhase    => rstAudPhase
    );

    --Serial clock generator and router.
    ser_clock_gen_0 : entity work.SER_clock_gen
    port map
    ( 
        clk          => clk,
        SKCTLS       => SKCTLS,
        resyncSerClk => resyncSerClk,
        Timer2       => Timer(2),
        Timer4       => Timer(4),
        BCLK_in      => BCLK_in,
        BCLK_out     => BCLK_out,
        sdiClock     => sdiClock,
        sdoClock     => sdoClock,
        OCLK         => OCLK
    );

    --Serial out module.
    serout_0 : entity work.SEROUT
    port map
    ( 
        clk            => clk,
        D              => D,
        AddrDw         => AddrDw,
        Init           => init,
        sdoClock       => sdoClock,
        SKCTLS7        => SKCTLS7,
        SKCTLS3        => SKCTLS3,
        Timer1         => Timer(1),
        Timer2         => Timer(2),
        resync2Tones   => resyncTwoTones,
        sdoFinish      => sdoFinish,
        setSdoComplete => setSdoComplete,
        SOD            => SOD
    );

    --Serial in module.
    serin_0 : entity work.SERIN
    port map
    (
        clk            => clk,
        SID            => SID,
        Init           => init,
        SKCTLS4        => SKCTLS(4),
        sdiClock       => sdiClock,
        D              => serialByte,
        siDelay        => siDelay,
        setFramerr     => setFramerr,
        setSdiCompl    => setSdiCompl,
        sdiBusy        => sdiBusy,
        resyncSerClock => resyncSerClk
    );

    process(all)
    begin
        if(falling_edge(clk)) then
            counter <= counter + '1';
            if(counter >= "100") then
                BCLK_in <= '0';
            else
                BCLK_in <= '1';
            end if;
        end if;
    end process;

    process
    begin
        --Clear serial clock resync.
        wait for 2000 ns;
        wait until falling_edge(clk);
        --resyncSerClk <= '0';
        --SKCTLS(6)    <= '1';

        --Set resync flip-flops into a known state.
        wait for 2000 ns;
        wait until rising_edge(clk);
        Addr9w <= '1';
        wait until rising_edge(clk);
        Addr9w <= '0';

        --Set resync flip-flops into a known state.
        --wait for 2000 ns;
        --wait until rising_edge(clk);
        --Addr9w <= '1';
        --wait until rising_edge(clk);
        --Addr9w <= '0';

        --Initialize clock pulse generator.
        wait until falling_edge(clk);
        init <= '1';
        wait for 9000 ns;
        wait until falling_edge(clk);
        init <= '0';

        --Load counter register 1.
        wait until falling_edge(clk);
        D <= "00000111";
        wait until rising_edge(clk);
        Addr0w <= '1';
        wait until falling_edge(clk);
        D <= "00000000";
        wait until rising_edge(clk);
        Addr0w <= '0';

        --Load counter register 2.
        wait until falling_edge(clk);
        D <= "00010000";
        wait until rising_edge(clk);
        Addr2w <= '1';
        wait until falling_edge(clk);
        D <= "00000000";
        wait until rising_edge(clk);
        Addr2w <= '0';

        --Load counter register 3.
        wait until falling_edge(clk);
        D <= "00000010";
        wait until rising_edge(clk);
        Addr4w <= '1';
        wait until falling_edge(clk);
        D <= "00000000";
        wait until rising_edge(clk);
        Addr4w <= '0';

        --Load counter register 4.
        wait until falling_edge(clk);
        D <= "00000000";
        wait until rising_edge(clk);
        Addr6w <= '1';
        wait until falling_edge(clk);
        D <= "00000000";
        wait until rising_edge(clk);
        Addr6w <= '0';

        --Set resync flip-flops into a known state.
        wait for 2000 ns;
        wait until rising_edge(clk);
        Addr9w <= '1';
        wait until rising_edge(clk);
        Addr9w <= '0';

        --Change clock config for async receive.
        wait for 2000 ns;
        wait until falling_edge(clk);
        SKCTLS <= "001";

        --Begin async receiving data.
        wait for 10000 ns;
        SID <= '0'; --Start bit.
        wait for 10000 ns;
        SID <= '1';
        wait for 10000 ns;
        SID <= '1';
        wait for 10000 ns;
        SID <= '0';
        wait for 10000 ns;
        SID <= '1';
        wait for 10000 ns;
        SID <= '0';
        wait for 10000 ns;
        SID <= '0';
        wait for 10000 ns;
        SID <= '0';
        wait for 10000 ns;
        SID <= '1';
        wait for 10000 ns;
        SID <= '0'; --Causes frame error. Should be a stop bit.
        wait for 10000 ns;
        SID <= '1';
        
        --Receive a second byte "11111111".
        wait for 10000 ns;
        SID <= '0';
        wait for 10000 ns;
        SID <= '1';

        --Wait for second byte to finish transmitting.
        wait for 100000 ns;

        --Change clock config for async receive.
        wait for 2000 ns;
        wait until falling_edge(clk);
        SKCTLS <= "010";

        --Receive a synchronous byte.
        wait until falling_edge(sdiClock);
        wait for 5000 ns;
        SID <= '0';
        wait until falling_edge(sdiClock);
        wait for 5000 ns;
        SID <= '1';
        wait until falling_edge(sdiClock);
        wait for 5000 ns;
        SID <= '0';
        wait until falling_edge(sdiClock);
        wait for 5000 ns;
        SID <= '1';
        wait until falling_edge(sdiClock);
        wait for 5000 ns;
        SID <= '0';
        wait until falling_edge(sdiClock);
        wait for 5000 ns;
        SID <= '1';
        wait until falling_edge(sdiClock);
        wait for 5000 ns;
        SID <= '0';
        wait until falling_edge(sdiClock);
        wait for 5000 ns;
        SID <= '1';
        wait until falling_edge(sdiClock);
        wait for 5000 ns;
        SID <= '0';
        wait until falling_edge(sdiClock);
        wait for 5000 ns;
        SID <= '1';

        --Load zeroes to transmit.
        --wait until falling_edge(clk);
        --D <= "00000000";
        --wait until rising_edge(clk);
        --AddrDw <= '1';
        --wait until falling_edge(clk);
        --D <= "00000000";
        --wait until rising_edge(clk);
        --AddrDw <= '0';        

        --Wait for TX to finish.
        --wait for 4600000 ns;
        --wait until sdoFinish = '0';

        --Set to 2 tone mode.
        --wait until falling_edge(clk);
        --SKCTLS3 <= '1';
        --wait for 2000 ns;

        --Load data to transmit.
        --wait until falling_edge(clk);
        --D <= "01001011";
        --wait until rising_edge(clk);
        --AddrDw <= '1';
        --wait until falling_edge(clk);
        --D <= "00000000";
        --wait until rising_edge(clk);
        --AddrDw <= '0';
        
        wait for 100000000 ns;
        std.env.stop; --End the simulation.
    end process;

end behavioral;
