nmikstas/atari_pokey/HDL/Verilog/Pokey_Cores/cell4.v

`timescale 1ns / 10ps

//**********************************************Cell 4**********************************************

module cell4
(
    input  enp,
    input  clk,
    input  D,
    input  Ld,
    output reg Q,
    output C
);
       
    //Flip-flop bit compare storage.
    always @(posedge clk) begin
        if(enp == 1'b1) begin
            if(Ld == 1'b1) begin
                Q  <= D;
            end
        end
    end

    //Output compare bit.
    assign C = Q ^ D;
endmodule
