nmikstas/atari_pokey/HDL/Verilog/Pokey_Cores/cell15.v

`timescale 1ns / 10ps

//**********************************************Cell 15*********************************************

module cell15
(
    input  enp,
    input  clk,
    input  Shift,
    input  Load,
    input  DIn,
    input  D,
    output Q 
);

    wire mux1, mux2;
    reg  Qint;

    //Always update the output.
    assign Q = Qint;

    //Shift cell.
    assign mux2 = (Shift == 1'b1) ? D : Qint;
    assign mux1 = (Load == 1'b1) ? DIn : mux2;

    //Load new value after slow clock rises.
    always @(posedge clk) begin
        if(enp == 1'b1) begin
            Qint <= mux1;
        end
    end

endmodule
