nmikstas/atari_pokey/(commit log)

2023-01-21 Made images for 2 registers and the 3 PLA circuits
2023-02-06 Laid out audio frequency control circuit images
2023-03-08 Fixed errors in the serial in IRQ signal and timer 4 signal
    [SERIN.vhd, SER_core.vhd, tb_POKEY_top.vhd]
2024-08-17 Began conversion to verilog
    [Prototype1.kicad_pcb, Prototype1.kicad_sch]
2024-08-24 Designed prototyping PCB
    [Prototype1.kicad_pcb, Prototype1.kicad_sch]
2024-09-08 Made prototype board and completed more verilog conversions
    [Prototype1-B_Cu.gbr, Prototype1-B_Mask.gbr, Prototype1-B_Paste.gbr, Prototype1-B_Silkscreen.gbr, Prototype1-Edge_Cuts.gbr, Prototype1-F_Cu.gbr, Prototype1-F_Mask.gbr, Prototype1-F_Paste.gbr]
2024-09-29 Finished verilog POKEY code
    [Prototype1.kicad_sch]
2024-10-20 Added new prototype PCBs
    [BOM.csv, Prototype1.kicad_sch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]
2024-11-11 Rearranged the repository
    [BOM.csv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]
2024-12-10 Added several new test boards
    [Extender_Board-B_Cu.gbr, Extender_Board-B_Mask.gbr, Extender_Board-B_Paste.gbr, Extender_Board-B_Silkscreen.gbr, Extender_Board-Edge_Cuts.gbr, Extender_Board-F_Cu.gbr, Extender_Board-F_Mask.gbr, Extender_Board-F_Paste.gbr]
